sdale28/MAE-322-DynaSaRR/Final_Design_Report/appendix-calculations.tex

\subsection{Calculations}
\begin{landscape}
\begin{figure}[ht]
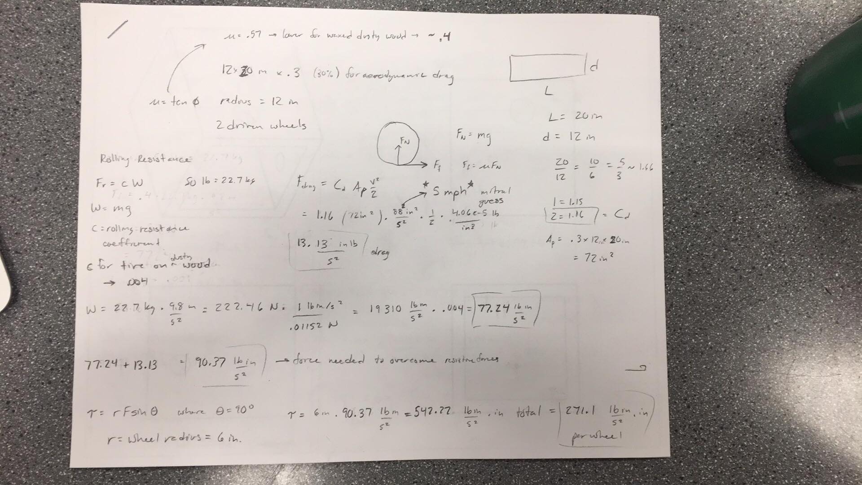
[picture p1: Final_Design_Report/Images/calculations1.png]
    
    \centering
    \caption{Numerical Values and Solutions, Part I}
\end{figure}

\vfill
\newpage

\begin{figure}[ht]
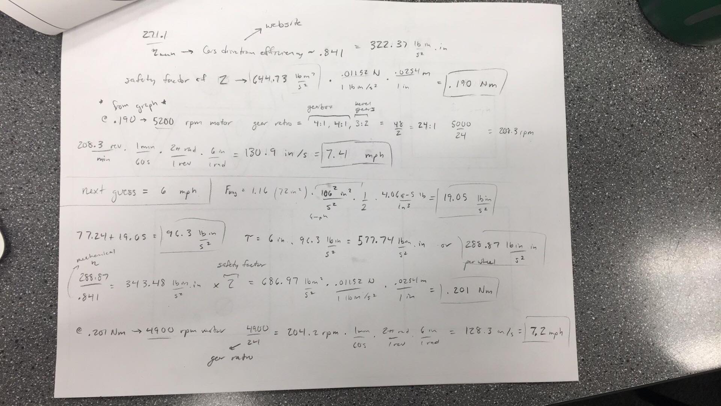
[picture p2: Final_Design_Report/Images/calculations2.png]
    
    \caption{Numerical Values and Solutions, Part II}
\end{figure}

\vfill
\newpage

\begin{figure}[ht]
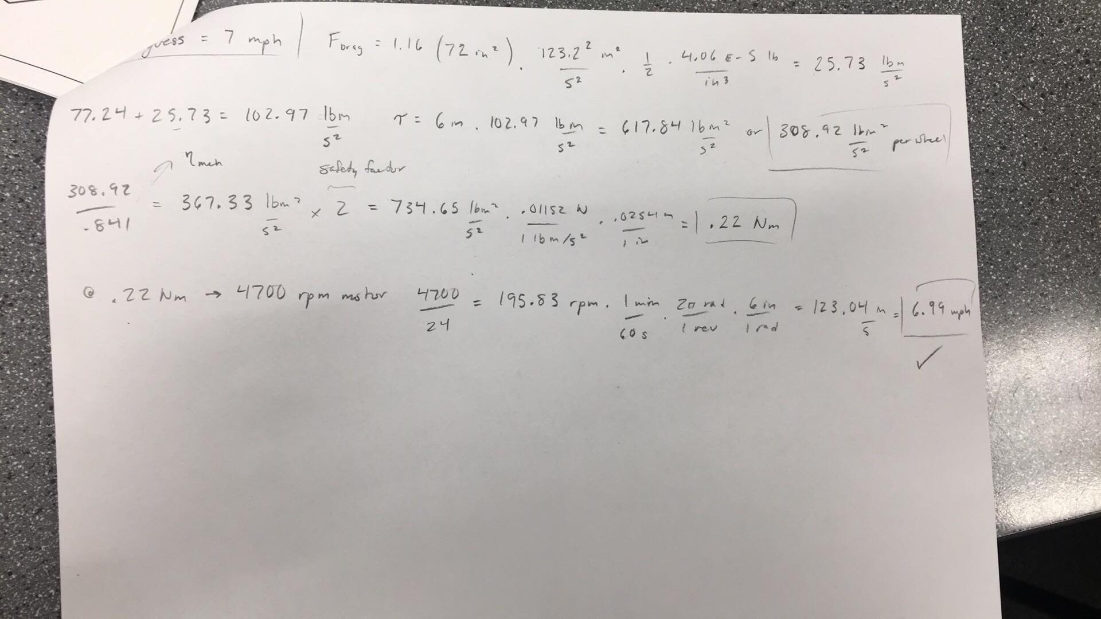
[picture p3: Final_Design_Report/Images/Calculations3.png]
    
    \caption{Numerical Values and Solutions, Part III}
\end{figure}

\vfill
\newpage

\begin{figure}[ht]
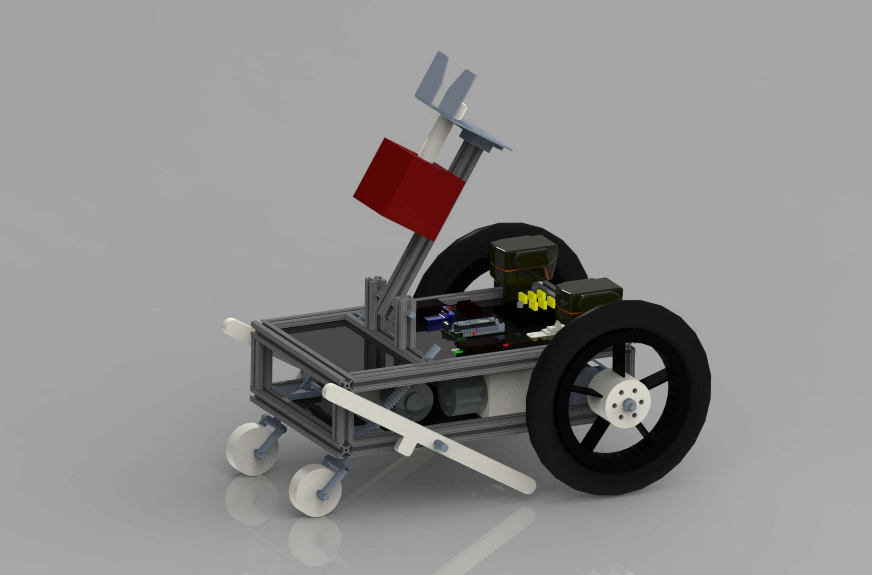
[picture p4: Final_Design_Report/Images/medkit_arm.png]
    
    \caption{Medical Kit Arm}
\end{figure}

\vfill
\newpage

\label{fig:GearStress}
\begin{figure}[ht]
    
    \caption{Gear Stress Calculations}
    \label{fig:GearStress}
\end{figure}

\vfill
\newpage
\clearpage
\end{landscape}
