sdale28/MAE-322-DynaSaRR/Final_Design_Report/appendix-drawings.tex

\subsection{Appendix III: Part and Sub-Assembly Drawings}

\begin{landscape}
\includepdf[pages={-},angle=90]{./drawings/1010_10_drawing}
\includepdf[pages={-},angle=90]{./drawings/1010_14_drawing}
\includepdf[pages={-},angle=90]{./drawings/1010_3_drawing}
\includepdf[pages={-},angle=90]{./drawings/1010_medkit_rester_drawing}
\includepdf[pages={-},angle=90]{./drawings/1010_medkit_support_drawing}
\includepdf[pages={-},angle=90]{./drawings/1010_medkitarm_final_drawing}
\includepdf[pages={-},angle=90]{./drawings/back_hub_gripper}
\includepdf[pages={-},angle=90]{./drawings/backaxle_drawing}
\includepdf[pages={-},angle=90]{./drawings/backwheel_motor_mount}
\includepdf[pages={-},angle=90]{./drawings/baxle}
\includepdf[pages={-},angle=90]{./drawings/bottom_poly_cnc}
\includepdf[pages={-},angle=90]{./drawings/chain_guard}
\includepdf[pages={-},angle=90]{./drawings/coupling_drawing}
\includepdf[pages={-},angle=90]{./drawings/cross_bar}
\includepdf[pages={-},angle=90]{./drawings/fork_mount_v3_left_drawing}
\includepdf[pages={-},angle=90]{./drawings/front_axle_drawing}
\includepdf[pages={-},angle=90]{./drawings/front_fork}
\includepdf[pages={-},angle=90]{./drawings/front_wheel_drawing}
\includepdf[pages={-},angle=90]{./drawings/gear_box}
\includepdf[pages={-},angle=90]{./drawings/gearbox_support}
\includepdf[pages={-},angle=90]{./drawings/grabber_drawing}
\includepdf[pages={-},angle=90]{./drawings/half-t-slot-v2}
\includepdf[pages={-},angle=90]{./drawings/hub_gripper_rear_drawing}
\includepdf[pages={-},angle=90]{./drawings/lifting_arm_axle_drawing}
\includepdf[pages={-},angle=90]{./drawings/lifting_arm_drawing}
\includepdf[pages={-},angle=90]{./drawings/lifting_arm_metal_gripper}
\includepdf[pages={-},angle=90]{./drawings/Lifting_Arm_Motor_Support_Cross}
\includepdf[pages={-},angle=90]{./drawings/lifting_arm_mount}
\includepdf[pages={-},angle=90]{./drawings/lifting_arm_support_cross}
\includepdf[pages={-},angle=90]{./drawings/lifting_arm_washer_plate}
\includepdf[pages={-},angle=90]{./drawings/lifting_motor_mount}
\includepdf[pages={-},angle=90]{./drawings/}
\includepdf[pages={-},angle=90]{./drawings/light-sensor_tap}
\includepdf[pages={-},angle=90]{./drawings/medkit_arm_gear_spacer_drawing}
\includepdf[pages={-},angle=90]{./drawings/medkit_axle_drawing}
\includepdf[pages={-},angle=90]{./drawings/medkit_grabber_attchmnt_drawing}
\includepdf[pages={-},angle=90]{./drawings/medkit_limit_switch_holder_frnt}
\includepdf[pages={-},angle=90]{./drawings/medkit_limit_switch_holder_rear}
\includepdf[pages={-},angle=90]{./drawings/medkit_motor_mount_bottom}
\includepdf[pages={-},angle=90]{./drawings/medkit_motor_mount_top}
\includepdf[pages={-},angle=90]{./drawings/medkit_secure_l_beam}
\includepdf[pages={-},angle=90]{./drawings/medkit_washer_plate_drawing_bottom}
\includepdf[pages={-},angle=90]{./drawings/top_cross_bar}
\includepdf[pages={-},angle=90]{./drawings/washer-plate-drawing.pdf}

\end{landscape}
