sdale28/MAE-322-DynaSaRR/Final_Design_Report/drawings.tex

\section{Creo Rendering and Drawings of Important Sub-Assemblies}

\begin{figure}[ht]
    \centering
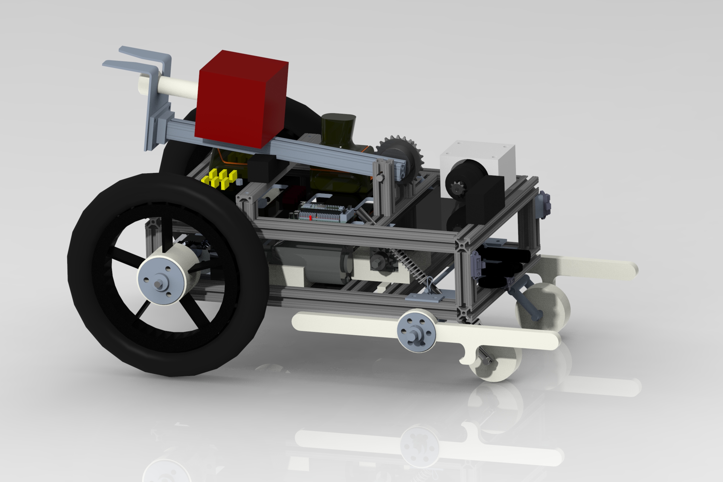
[picture p24: Final_Design_Report/Images/FDR_pretty_picture_2.jpg]
    
    \caption{Final rendering of DynaSaRR}
\end{figure}

\begin{landscape}
\includepdf[pages={-},angle=90]{./drawings/front_wheel_subassembly}
\includepdf[pages={-},angle=90]{./drawings/gearbox_subassembly_drawing}
\includepdf[pages={-},angle=90]{./drawings/medkit_subassembly_v2}
\end{landscape}
