sdale28/MAE-322-DynaSaRR/Final_Design_Report/final-report.tex

\documentclass[12pt]{article}
\usepackage[english]{babel}
\usepackage[utf8x]{inputenc}
\usepackage{amsmath}
\usepackage{graphicx}
\usepackage[colorinlistoftodos]{todonotes}
\usepackage{array}
\usepackage{multirow}
\usepackage{tabularx}
\usepackage{textcomp}
\usepackage{gensymb}
\usepackage{listings}
\usepackage{courier}
\usepackage{fancyhdr}
\usepackage{nameref}
\usepackage{pdflscape}
\usepackage{rotating}
\usepackage{csvsimple}
\usepackage{longtable}
\usepackage{pdfpages}

\input{./resources/commands.tex}
\graphicspath{ {Images/} }

\input{./resources/arduinoLanguage.tex}
\input{./resources/arduinoStyle.tex}

\begin{document}

\frontmatter
\input{./resources/title-page.tex}
\input{executive-summary.tex}

\tableofcontents
\newpage

\mainmatter
\input{introduction.tex}
\input{project-management.tex}
\input{detailed-design-and-analysis.tex}
\input{specifications.tex}
\input{drawings.tex}
\input{test-results.tex}
\input{further-work-and-conclusions.tex}

\backmatter
\section{Appendices}
\input{appendix-calculations.tex}
%\input{appendix-logbook.tex}
\input{appendix-bill-of-materials.tex}
\input{appendix-code.tex}
\input{appendix-drawings.tex}

\end{document}
