sdale28/MAE-322-DynaSaRR/Final_Design_Report/resources/title-page.tex

% Title page template downloaded from: 
% https://www.overleaf.com/latex/examples/title-page-with-logo/hrskypjpkrpd

%\documentclass[12pt]{article}
%\usepackage[english]{babel}
%\usepackage[utf8x]{inputenc}
%\usepackage{amsmath}
%\usepackage{graphicx}
%\usepackage[colorinlistoftodos]{todonotes}

%\begin{document}

\begin{titlepage}

\newcommand{\HRule}{\rule{\linewidth}{0.5mm}} % Defines a new command for the horizontal lines, change thickness here

\center % Center everything on the page
 
%-----------------------------------------------------------------------------------
%	HEADING SECTIONS
%-----------------------------------------------------------------------------------
\\[1cm]
%\textsc{\LARGE Princeton University}\\[1.5cm] % Name of your university/college
\textsc{\Large MAE 322: Mechanical Design}\\[0.5cm] % Major heading such as course name
\textsc{\large Spring 2019}\\[1cm] % Minor heading such as course title

%-----------------------------------------------------------------------------------
%	TITLE SECTION
%-----------------------------------------------------------------------------------

\HRule \\[0.6cm]
{ \huge \bfseries Final Design Report}\\[0.4cm] % Title of your document
\HRule \\[1cm]

{\Large May 14, 2019}\\[2cm] % Date, change the \today to a set date if you want to be precise

%-----------------------------------------------------------------------------------
%	Team Info
%-----------------------------------------------------------------------------------

{\large \textbf{Team:} The SaRRchaeologists}\\[1cm]
{\large \textbf{Robot:} DynaSaRR}\\[1.6cm]

\begin{minipage}[t]{0.4\textwidth}
\begin{flushleft} \large
\emph{Submitted By:}\\
Jackson Artis\\
Morgan Baker\\
Sam Dale\\
Alexandra Koskosidis\\
Evan Quinn\\
Alex Rogers
\end{flushleft}
\end{minipage}
~
\begin{minipage}[t]{0.4\textwidth}
\begin{flushright} \large
\emph{Submitted To:} \\
Prof. Daniel Nosenchuck\\
Glenn Northey\\
Al Gaillard\\
Aaron Goodman\\
\end{flushright}
\end{minipage}\\[1cm]

\vfill % Fill the rest of the page with whitespace

\end{titlepage}

%\end{document}
