sdale28/MAE-322-DynaSaRR/Final_Design_Report/team-roles.tex

%{\Large \textbf{Team Roles}}

\addcontentsline{toc}{section}{Team Roles}
\section*{Team Roles}

% \begin{minipage}[t]{0.4\textwidth}
%     \begin{itemize}
%     \item Column 2 content 1
%     \item Column 2 content 2
%     \end{itemize}
%   \end{minipage}

\begin{center}
\resizebox{\textwidth}{!}{
\begin{tabular}{ |c|c|c|c| } 
    \hline
    \textbf{Name} & \textbf{Responsible For} \\
    \hline
    Jackson Artis & CAD Modeling \\
    \hline
    Morgan Baker & Analysis \\
    \hline
    Sam Dale & Design, Electronics \\
    \hline
    Alexandra Koskosidis & Team Leader, Coding \\
    \hline
    Evan Quinn &  Manufacturing \\
    \hline
    Alex Rogers & CNC, Hardware Systems \\ 
    \hline
    
\end{tabular}}
\end{center}

\vfill % Fill the rest of the page with whitespace
\newpage
