sdale28/MAE-322-DynaSaRR/Final_Design_Report/resources/total-time_v1.csv

Person | Time | Percent of Time
Alexandra Koskosidis | 165:20 | 20.21%
Alex Rogers | 119:35 | 14.61%
Evan Quinn | 95:30 | 11.67%
Jackson Artis | 110:25 | 13.49%
Morgan Baker | 123:00 | 15.03%
Sam Dale | 204:25 | 24.98%
 | 818:15 | 100%
