sdale28/MAE-322-DynaSaRR/Final_Design_Report/Images/chassis_COM.PNG

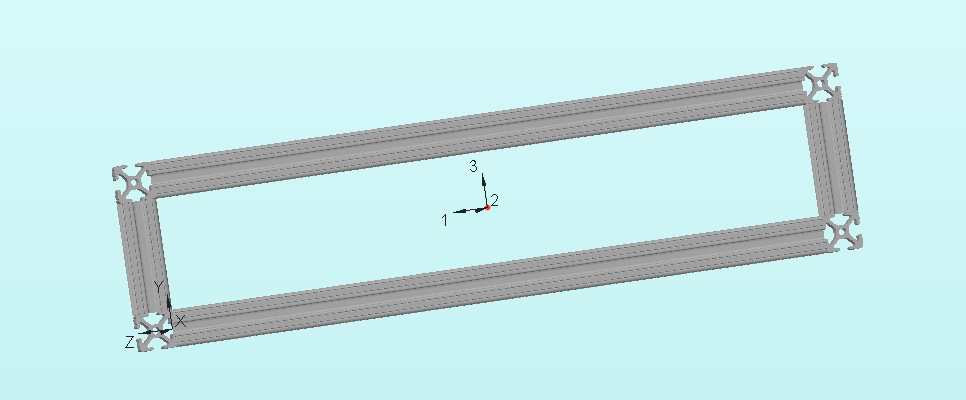
Final_Design_Report/Images/chassis_COM.PNG
