sdale28/MAE-322-DynaSaRR/Final_Design_Report/Images/Code-Diagram.png

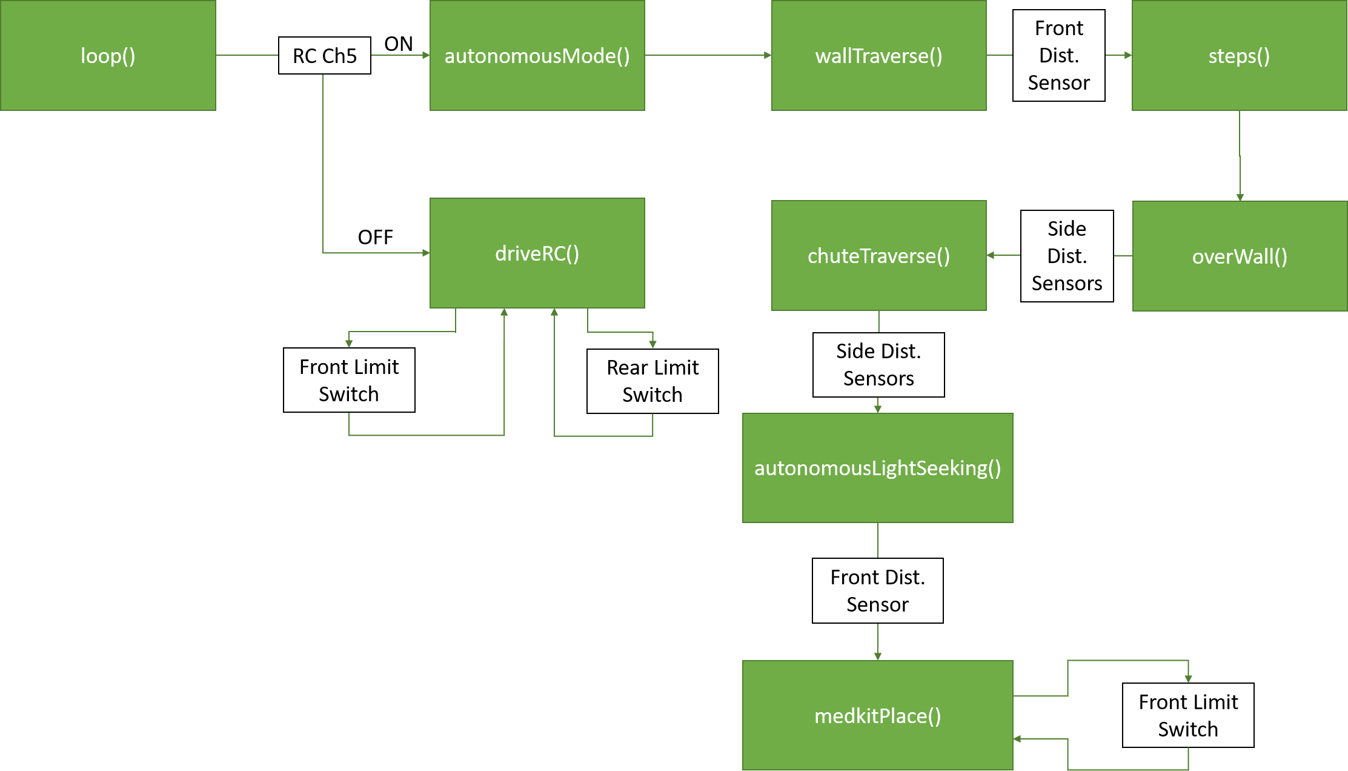
Final_Design_Report/Images/Code-Diagram.png
