sdale28/MAE-322-DynaSaRR/Final_Design_Report/appendix-bill-of-materials.tex

\begin{landscape}
\subsection{Bill of Materials}
% Please add the following required packages to your document preamble:
% \usepackage{lscape}
% \usepackage{longtable}
% Note: It may be necessary to compile the document several times to get a multi-page table to line up properly
{\footnotesize
\begin{longtable} {llllll}
\hline
Part Number & Part Name                    & Description                          & Quantity & Price Per Unit & Cost    \\ \hline
\endfirsthead
%
\endhead
%
\hline
\endfoot
%
\endlastfoot
%
6529K11     & Metal Miter Gear             & 16 Pitch, 16 Teeth                   & 2        & \$25.32        & \$50.64 \\
6529K16     & Metal Miter Gear             & 16 Pitch, 24 Teeth                   & 2        & \$32.86        & \$65.72 \\
8619K851    & HDPE Sheet                   & 6"x12"x1"                            & 1        & \$20.01        & \$20.01 \\
9657K435    & 6-Pack, Compression Spring   & 3", 0.66" OD                         & 1        & \$7.82         & \$7.82  \\
9657K437    & 6-Pack, Compression Spring   & 3", 0.72" OD                         & 1        & \$8.86         & \$8.86  \\
9620K25     & Steel Compression Spring     & 3", 0.781" OD                        & 1        & \$4.37         & \$4.37  \\
9414T8      & Set Screw Collar             & 3/8" Diameter                        & 8        & \$1.30         & \$10.40 \\
92391A120   & 25-Pack Hairpin Cotter Pin   & 1/4"-1/2" Clevis Diameter            & 1        & \$8.00         & \$8.00  \\
92949A540   & 50-Pack Button Head Screw    & 1/4"-20, 3/4" Long                   & 1        & \$7.39         & \$7.39  \\
87225K62    & Clear Polycarbonate Sheet    & 12"x24"x1/4"                         & 1        & \$26.13        & \$26.13 \\
8624K46     & HDPE Rod                     & 3"x1'                                & 1        & \$23.10        & \$23.10 \\
6546K31     & 6061 Aluminum Rect. Tube     & 1/4" thick, 2.5"x2.5", 1/2'          & 1        & \$19.08        & \$19.08 \\
47065T68    & T-Slotted Framing            & 1"x1/2"x2'                           & 1        & \$7.98         & \$7.98  \\
6338K414    & Sleeve Bearing               & 3/8" SD, 1/2" HD, 1/4" long          & 4        & \$0.74         & \$2.96  \\
7297K15     & Plastic Miter Gear           & 24 Pitch, 24 Teeth                   & 2        & \$5.39         & \$10.78 \\
7297K17     & Plastic Miter Gear           & 24 Pitch, 36 Teeth                   & 2        & \$5.44         & \$10.88 \\
6338K411    & Sleeve Bearing               & 1/4" SD, 3/8" HD                     & 4        & \$0.67         & \$2.68  \\
6338K462    & Sleeve Bearing               & 7/16" SD, 9/16" HD                   & 4        & \$1.12         & \$4.48  \\
47065t95    & 1" 80/20                     & 2ft long                             & 1        & \$7.79         & \$7.79  \\
6338K421    & Sleeve Bearing               & 1/2'' SD, 5/8'' HD, 1'' long         & 2        & \$1.44         & \$2.88  \\
1346K18     & Steel Shaft                  & 1/2" diameter, 24" long              & 1        & \$17.47        & \$17.47 \\
8671K73     & HDPE Bar                     & 4"x1/2"x4'                           & 4        & \$5.29         & \$21.16 \\
92949A540   & 50-Pack Button Head Screw    & 1/4"-20, 3/4" Long                   & 1        & \$7.39         & \$7.39  \\
98381A508   & 50-Pack Dowel Pin            & 3/16" diameter, 3/4" long            & 1        & \$7.80         & \$7.80  \\
8893K178    & Drill Rod                    & 0.1875" diameter, 3' long            & 1        & \$4.30         & \$4.30  \\
47065T95    & T-Slotted Framing            & 1" High x 1" Wide, Solid             & 1        & \$7.79         & \$7.79  \\
89015K18    & 6061 Aluminum Sheet          & 1/8" Thick, 12" x 12"                & 1        & \$27.71        & \$27.71 \\
6338K312    & Brass Flanged Sleeve Bearing & 5/8" Flange OD                       & 6        & \$1.12         & \$6.72  \\
9414T8      & Set Screw Shaft Collar       & for 3/8" Diameter, 1215 Carbon Steel & 2        & \$1.30         & \$2.60  \\ \hline
\end{longtable}
\end{landscape}
}
