sdale28/MAE-322-DynaSaRR/Final_Design_Report/drawings/1010_10_drawing.pdf

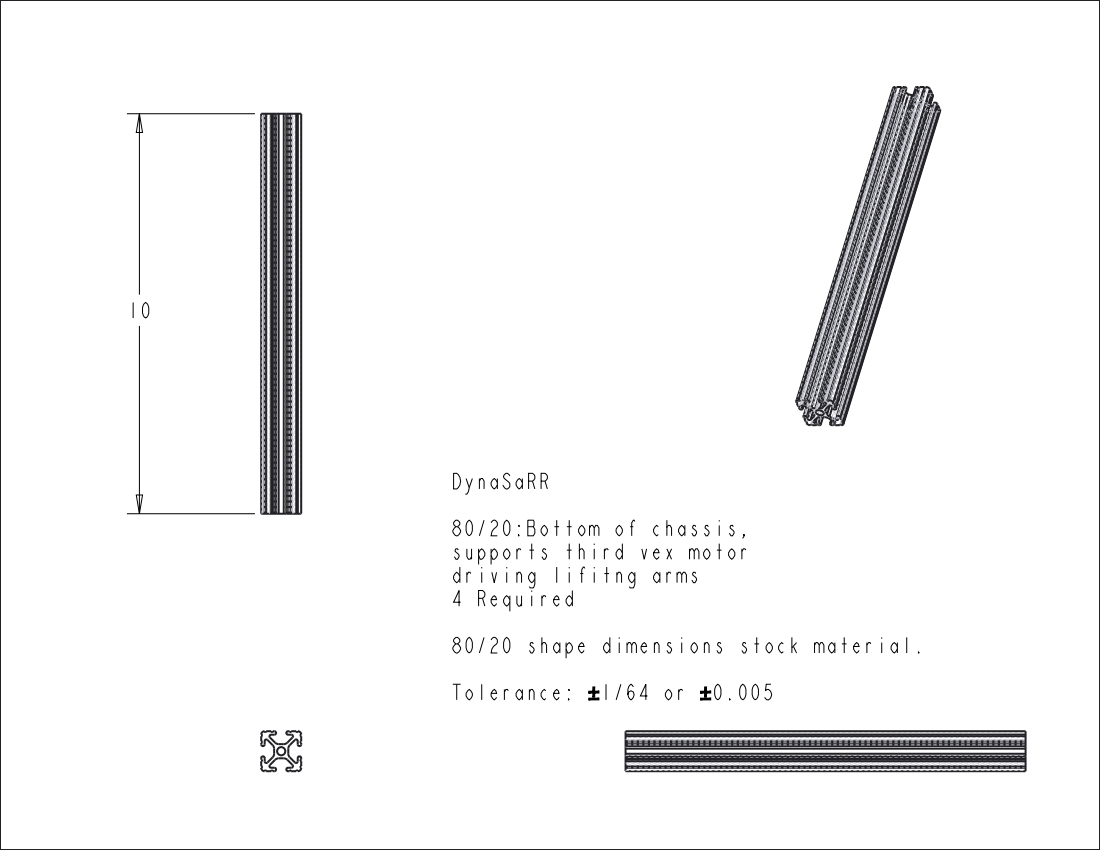
[picture p38: page 1]
supports third; vex motor; 80/20 shape dimensions stock; material.

DynaSaRR
80/20:Bottom of chassis,
driving lifitng arms
4 Required
Tolerance: 1/64 or 0.005
