sdale28/MAE-322-DynaSaRR/Final_Design_Report/drawings/1010_14_drawing.pdf

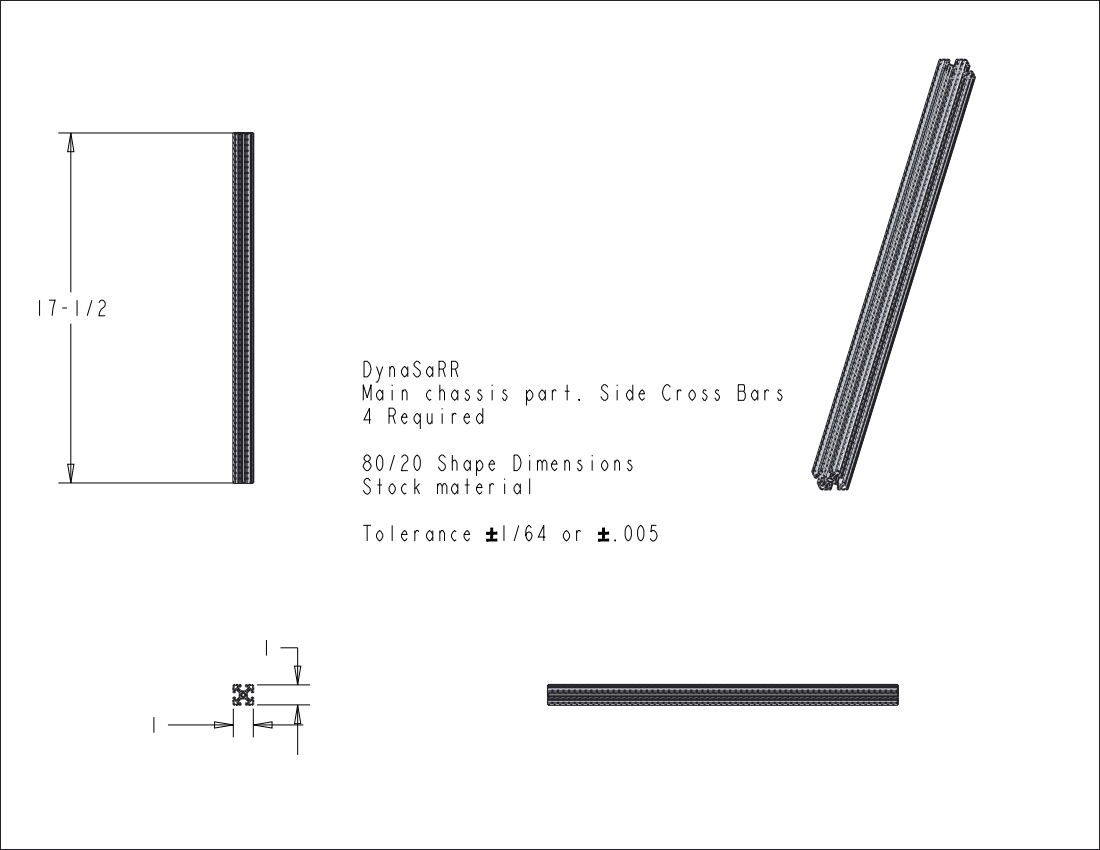
[picture p39: page 1]

DynaSaRR
Main chassis part. Side Cross Bars
4 Required
80/20 Shape Dimensions
Stock material
Tolerance 1/64 or .005
