sdale28/MAE-322-DynaSaRR/Final_Design_Report/drawings/1010_3_drawing.pdf

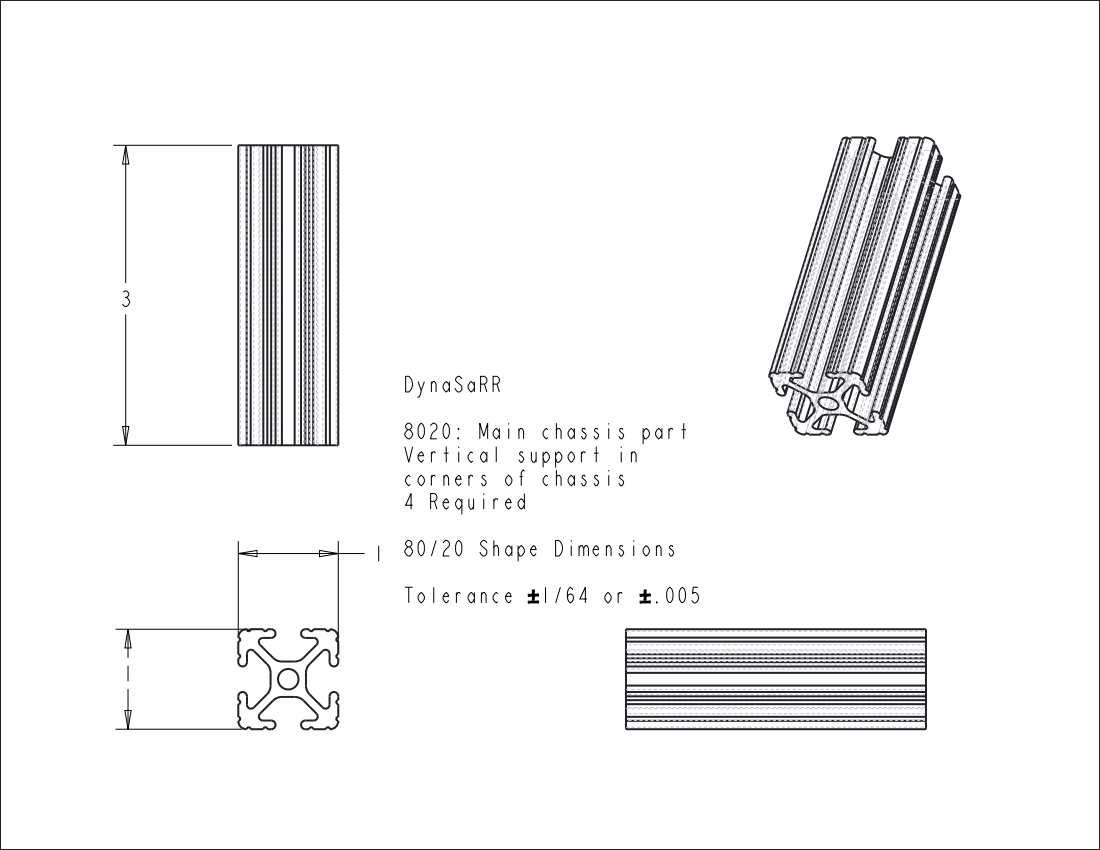
[picture p40: page 1]

DynaSaRR
8020: Main chassis part
Vertical support in
corners of chassis
4 Required
80/20 Shape Dimensions
Tolerance 1/64 or .005
