sdale28/MAE-322-DynaSaRR/Final_Design_Report/drawings/1010_medkit_rester_drawing.pdf

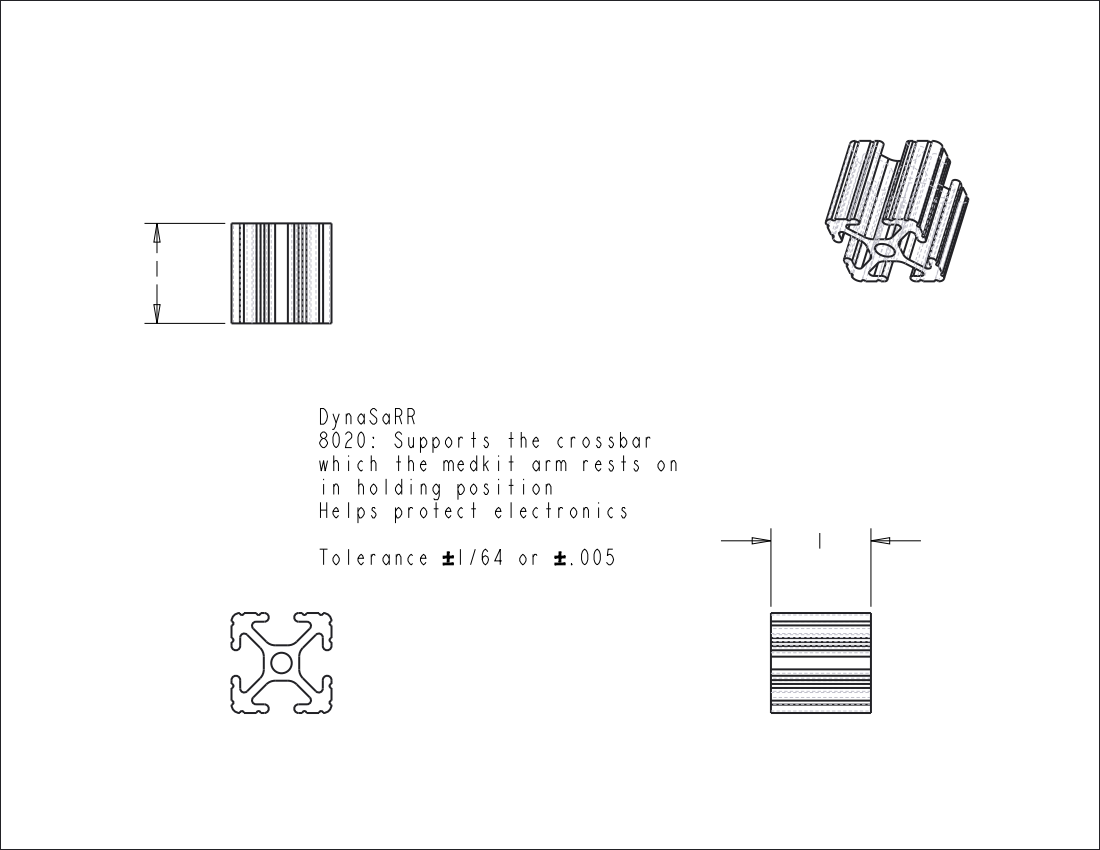
[picture p41: page 1]
which the medkit; arm rests on

DynaSaRR
8020: Supports the crossbar
in holding position
Helps protect electronics
Tolerance 1/64 or .005
