sdale28/MAE-322-DynaSaRR/Final_Design_Report/drawings/1010_medkit_support_drawing.pdf

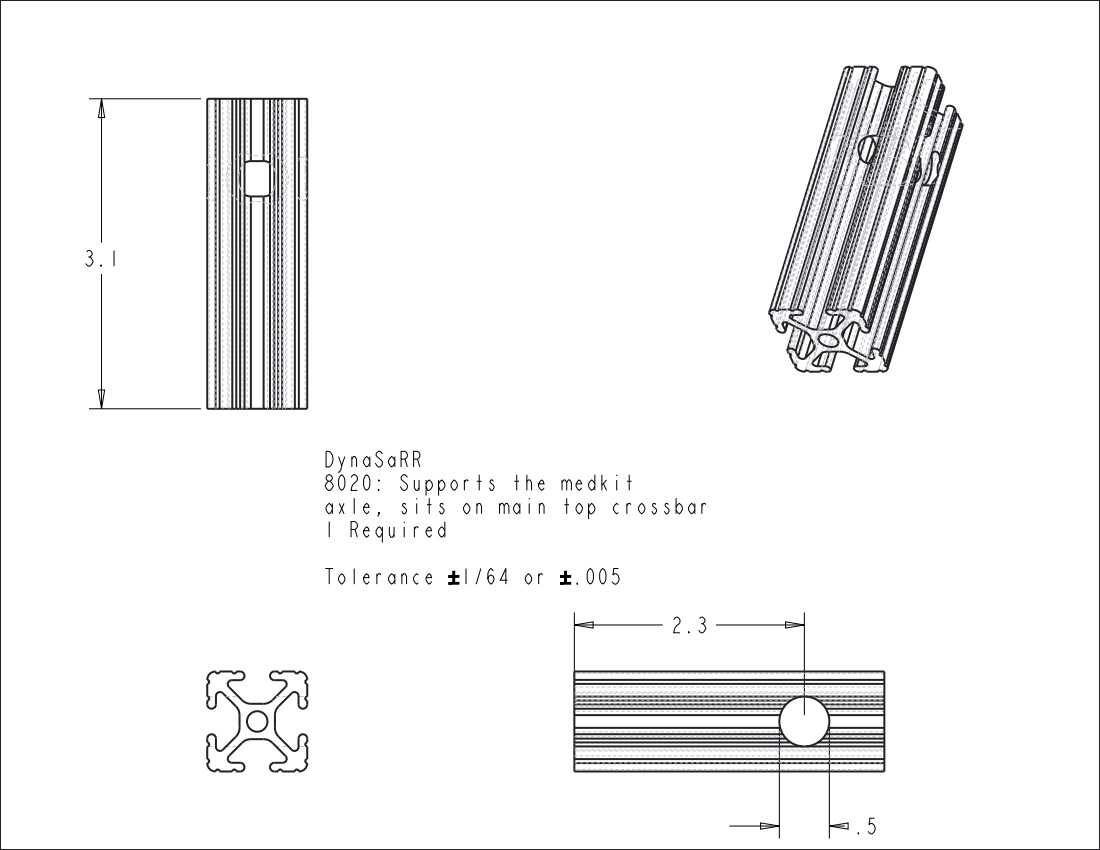
[picture p42: page 1]

DynaSaRR
8020: Supports the medkit
axle, sits on main top crossbar
1 Required
Tolerance 1/64 or .005
