sdale28/MAE-322-DynaSaRR/Final_Design_Report/drawings/1010_medkitarm_final_drawing.pdf

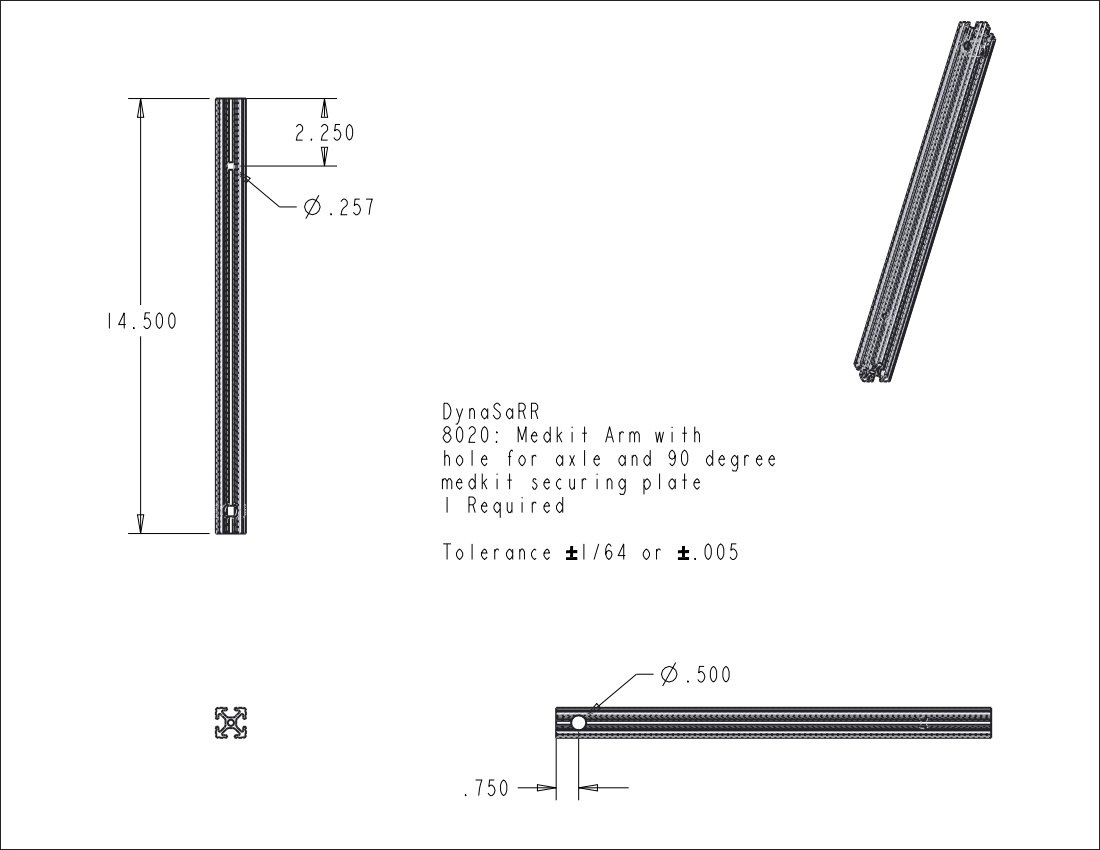
[picture p43: page 1]
hole for axle and; 90 degree

DynaSaRR
8020: Medkit Arm with
medkit securing plate
1 Required
Tolerance 1/64 or .005
