sdale28/MAE-322-DynaSaRR/Final_Design_Report/drawings/90_degree_gearbox_support_drawi.pdf

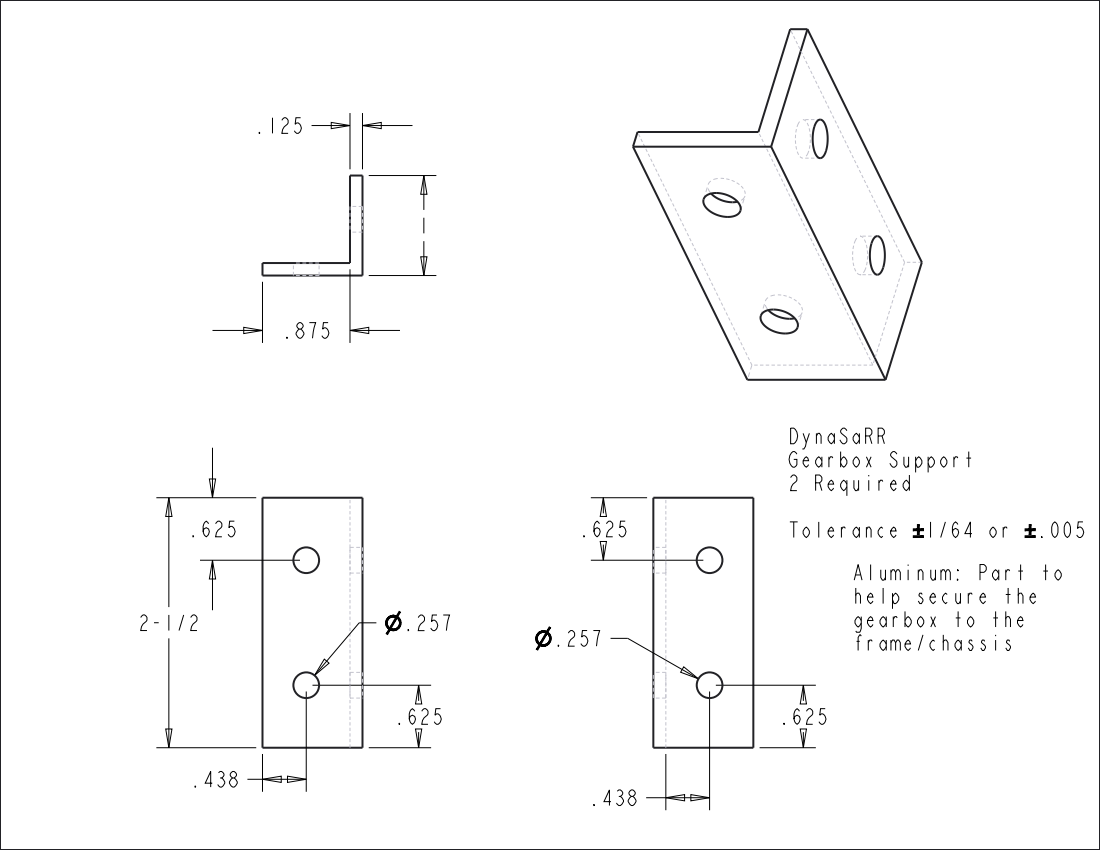
[picture p44: page 1]

DynaSaRR
Gearbox Support
2 Required
Tolerance 1/64 or .005
Aluminum: Part to
help secure the
gearbox to the
frame/chassis
