sdale28/MAE-322-DynaSaRR/Final_Design_Report/drawings/back_hub_gripper.pdf

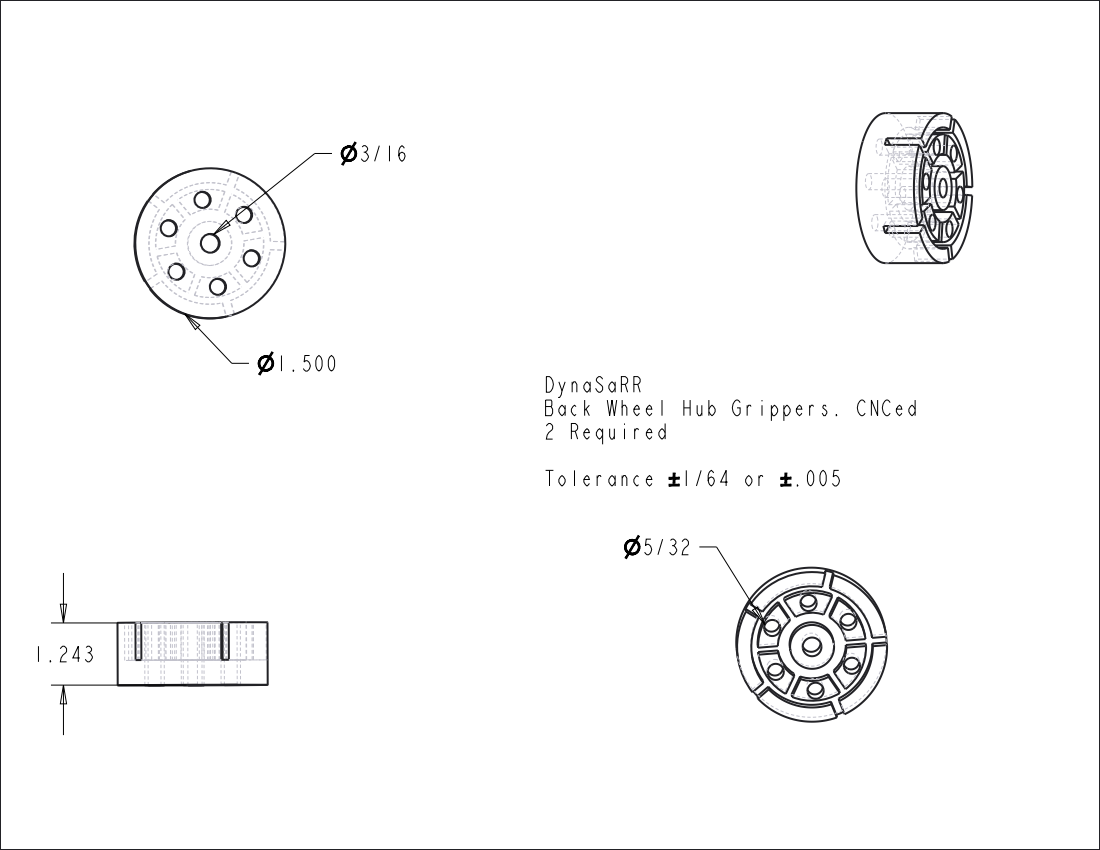
[picture p45: page 1]

DynaSaRR
Back Wheel Hub Grippers. CNCed
2 Required
Tolerance 1/64 or .005
