sdale28/MAE-322-DynaSaRR/Final_Design_Report/drawings/backaxle_drawing.pdf

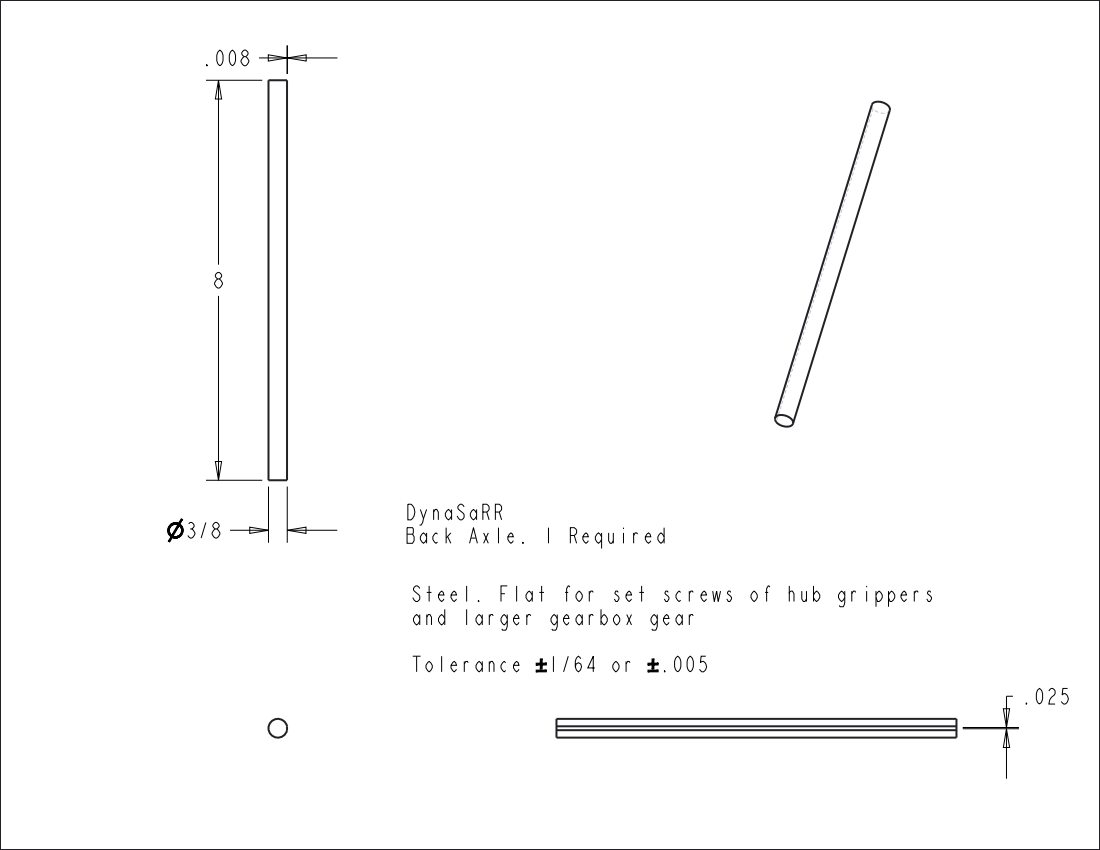
[picture p46: page 1]
Steel. Flat for set; screws of hub; grippers

DynaSaRR
Back Axle. 1 Required
and larger gearbox gear
Tolerance 1/64 or .005
