sdale28/MAE-322-DynaSaRR/Final_Design_Report/drawings/backwheel_motor_mount.pdf

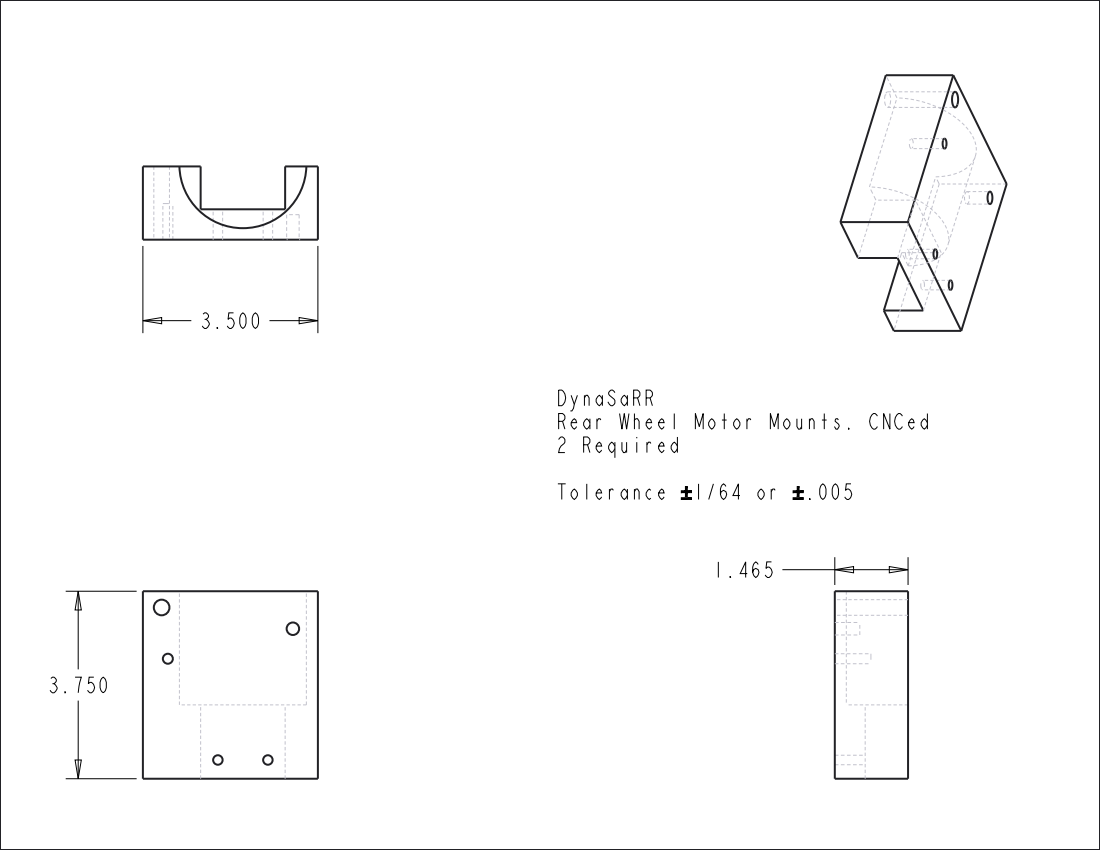
[picture p47: page 1]

DynaSaRR
Rear Wheel Motor Mounts. CNCed
2 Required
Tolerance 1/64 or .005
