sdale28/MAE-322-DynaSaRR/Final_Design_Report/drawings/baxle.pdf

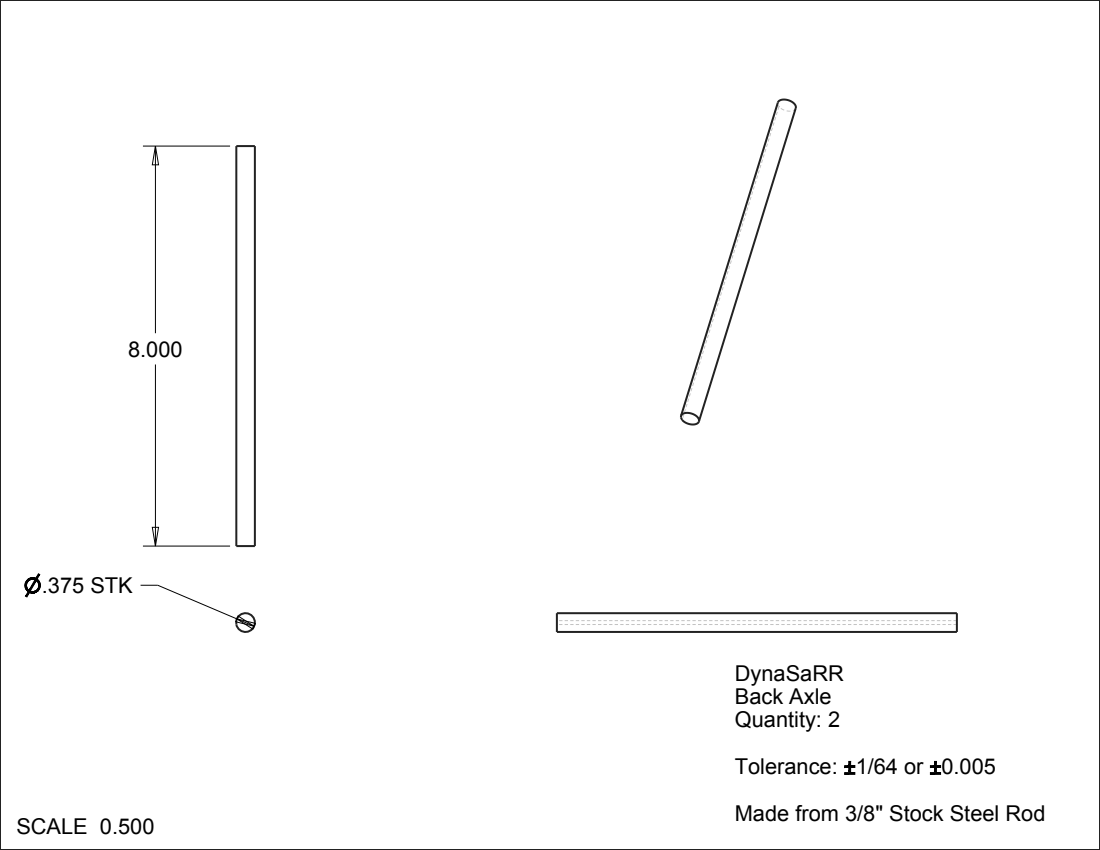
[picture p48: page 1]
.375 STK; DynaSaRR Back Axle Quantity: 2; Tolerance: 1/64 or 0.005

Made from 3/8" Stock Steel Rod SCALE 0.500
