sdale28/MAE-322-DynaSaRR/Final_Design_Report/drawings/bottom_poly_cnc.pdf

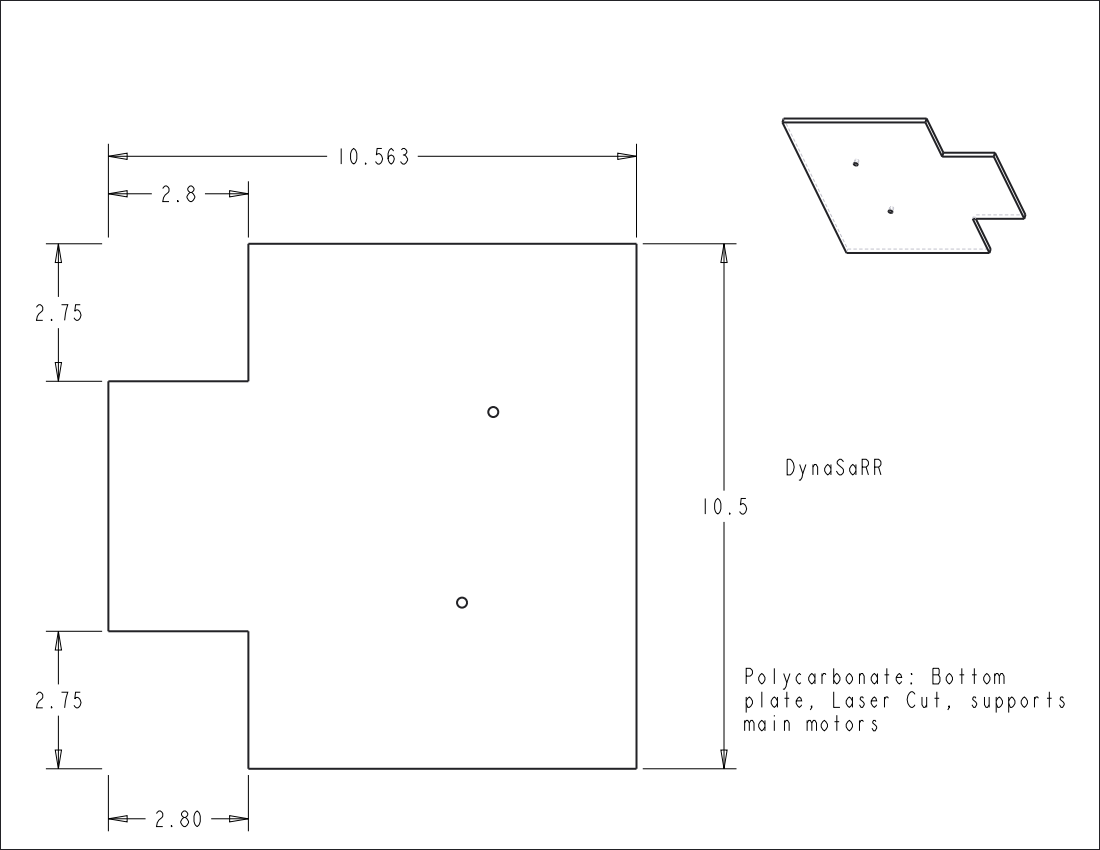
[picture p49: page 1]
DynaSaRR

Polycarbonate: Bottom
plate, Laser Cut, supports
main motors
