sdale28/MAE-322-DynaSaRR/Final_Design_Report/drawings/chain_guard.pdf

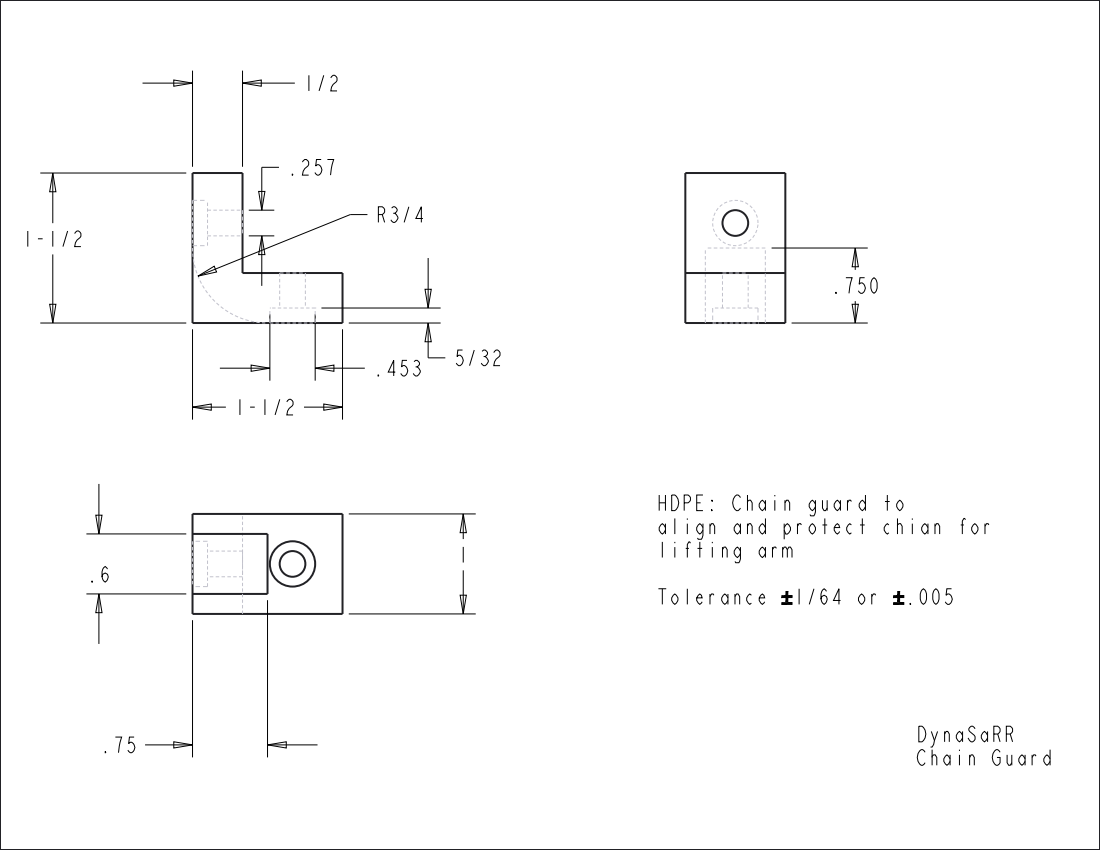
[picture p50: page 1]
DynaSaRR Chain Guard; HDPE: Chain guard; align and; protect; chian for; lifting arm Tolerance 1/64 or .005
