sdale28/MAE-322-DynaSaRR/Final_Design_Report/drawings/coupling_drawing.pdf

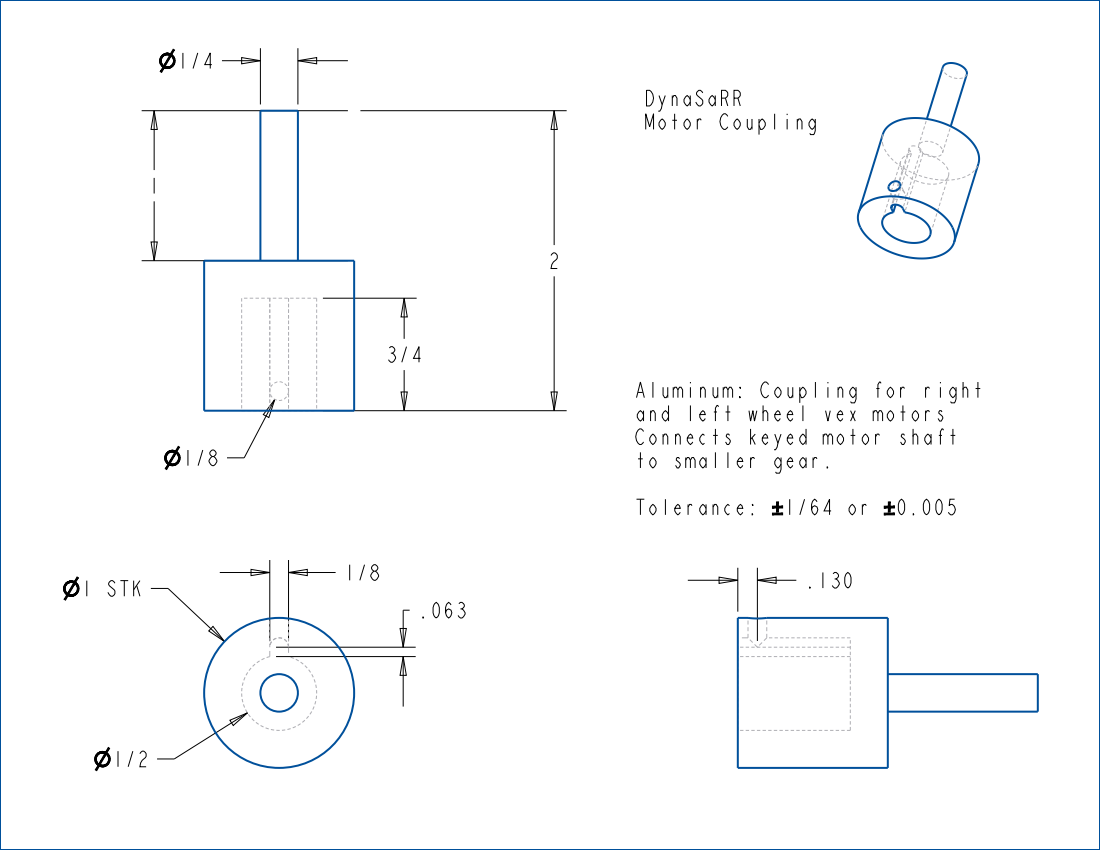
[picture p51: page 1]
1 STK; Connects keyed; motor shaft; DynaSaRR Motor Coupling

Aluminum: Coupling for right
and left wheel vex motors
to smaller gear.
Tolerance: 1/64 or 0.005
