sdale28/MAE-322-DynaSaRR/Final_Design_Report/drawings/fork_mount_v3_left_drawing.pdf

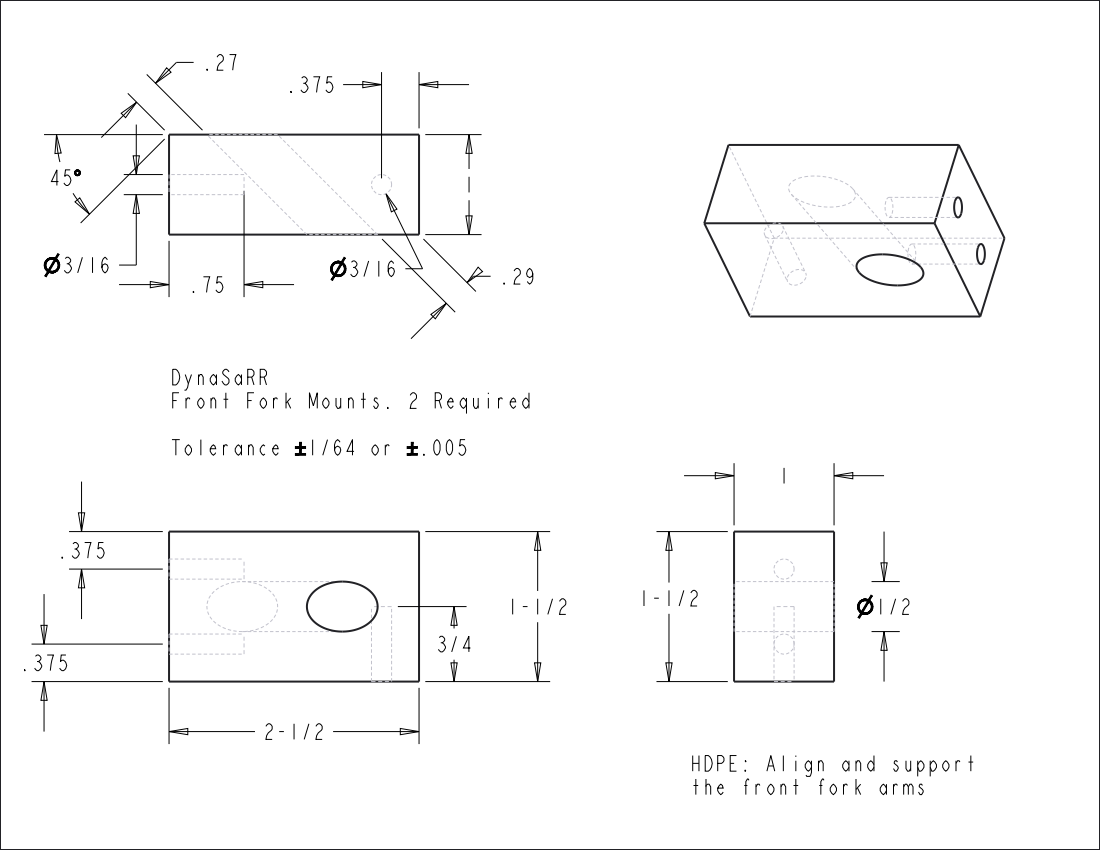
[picture p52: page 1]
HDPE: Align and; support

DynaSaRR
Front Fork Mounts. 2 Required
Tolerance 1/64 or .005

the front fork arms
