sdale28/MAE-322-DynaSaRR/Final_Design_Report/drawings/front_axle_drawing.pdf

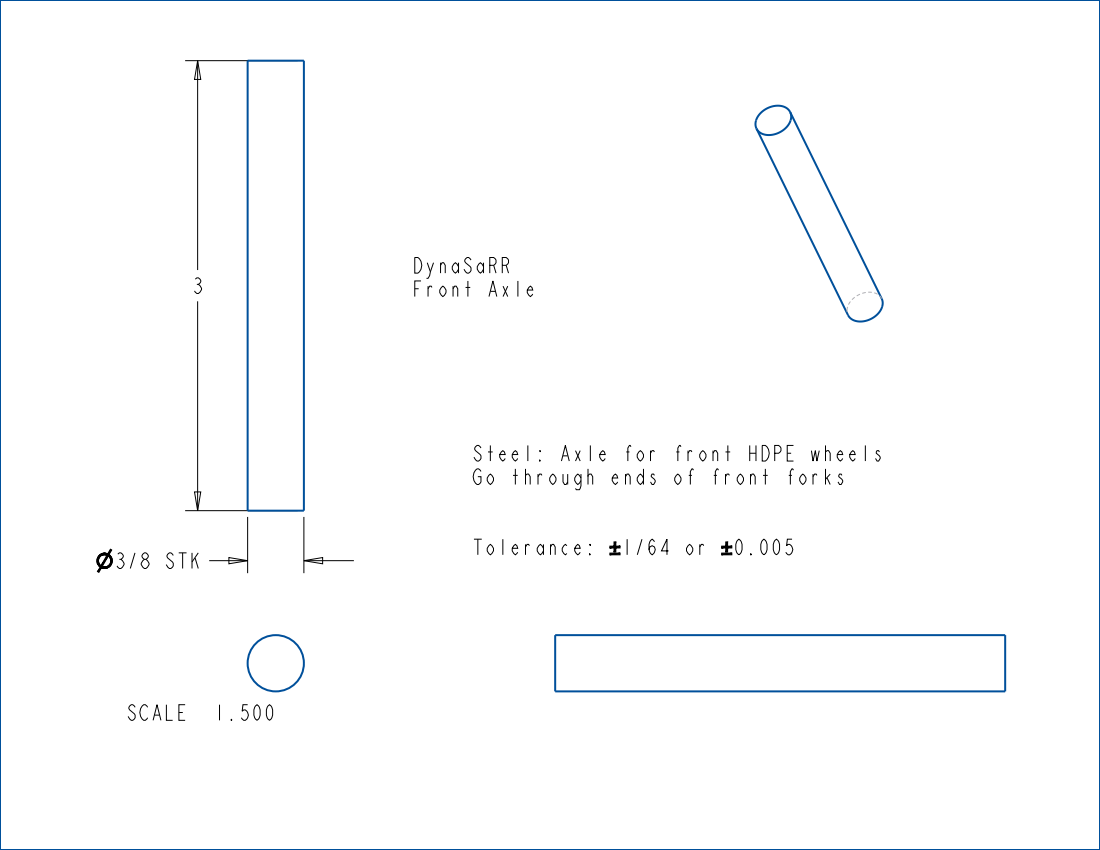
[picture p53: page 1]
3/8 STK; DynaSaRR Front Axle; Steel: Axle for front; HDPE wheels; Go through ends of front; forks; Tolerance: 1/64 or 0.005; SCALE 1.500
