sdale28/MAE-322-DynaSaRR/Final_Design_Report/drawings/front_fork.pdf

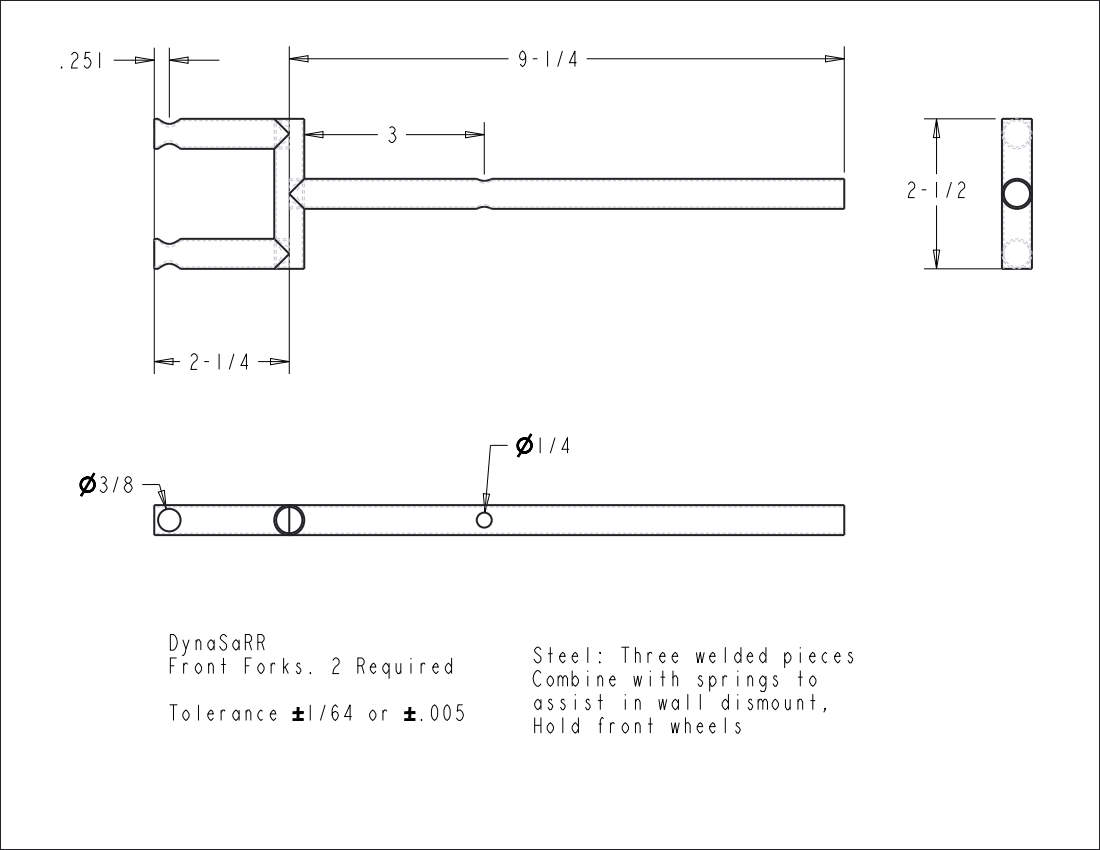
[picture p54: page 1]
Steel: Three welded; pieces

DynaSaRR
Front Forks. 2 Required
Tolerance 1/64 or .005

Combine with springs to
assist in wall dismount,
Hold front wheels
