sdale28/MAE-322-DynaSaRR/Final_Design_Report/drawings/front_wheel_drawing.pdf

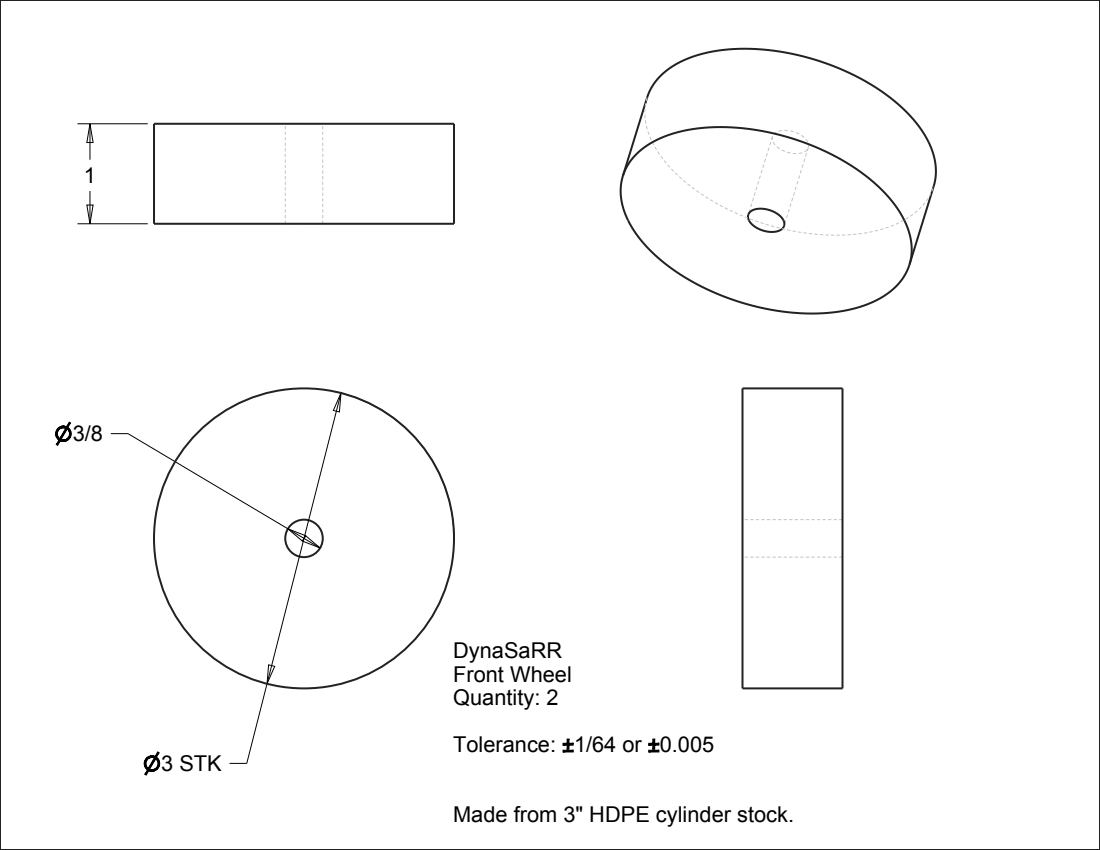
[picture p55: page 1]
3 STK; DynaSaRR Front Wheel Quantity: 2; Tolerance: 1/64 or 0.005

Made from 3" HDPE cylinder stock.
