sdale28/MAE-322-DynaSaRR/Final_Design_Report/drawings/front_wheel_subassembly.pdf

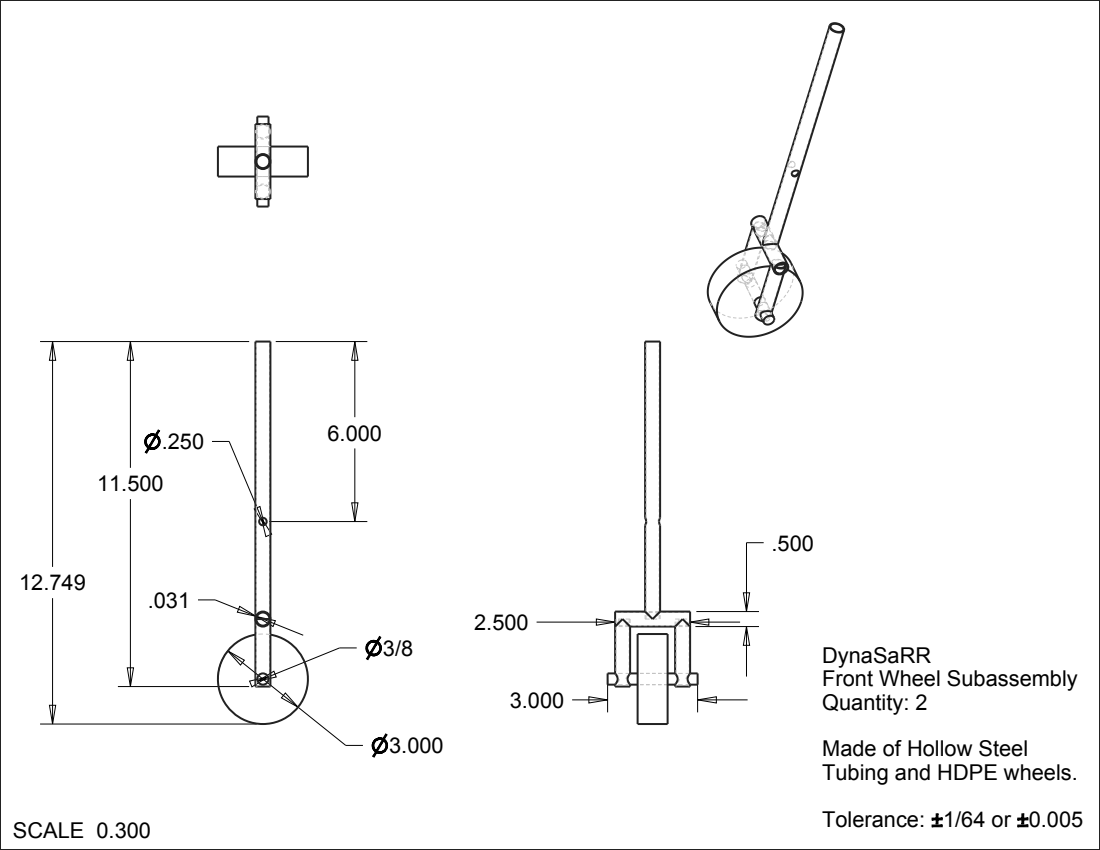
[picture p56: page 1]
DynaSaRR

Front Wheel Subassembly
Quantity: 2
Made of Hollow Steel
Tubing and HDPE wheels.

Tolerance: 1/64 or 0.005 SCALE 0.300
