sdale28/MAE-322-DynaSaRR/Final_Design_Report/drawings/gear_box.pdf

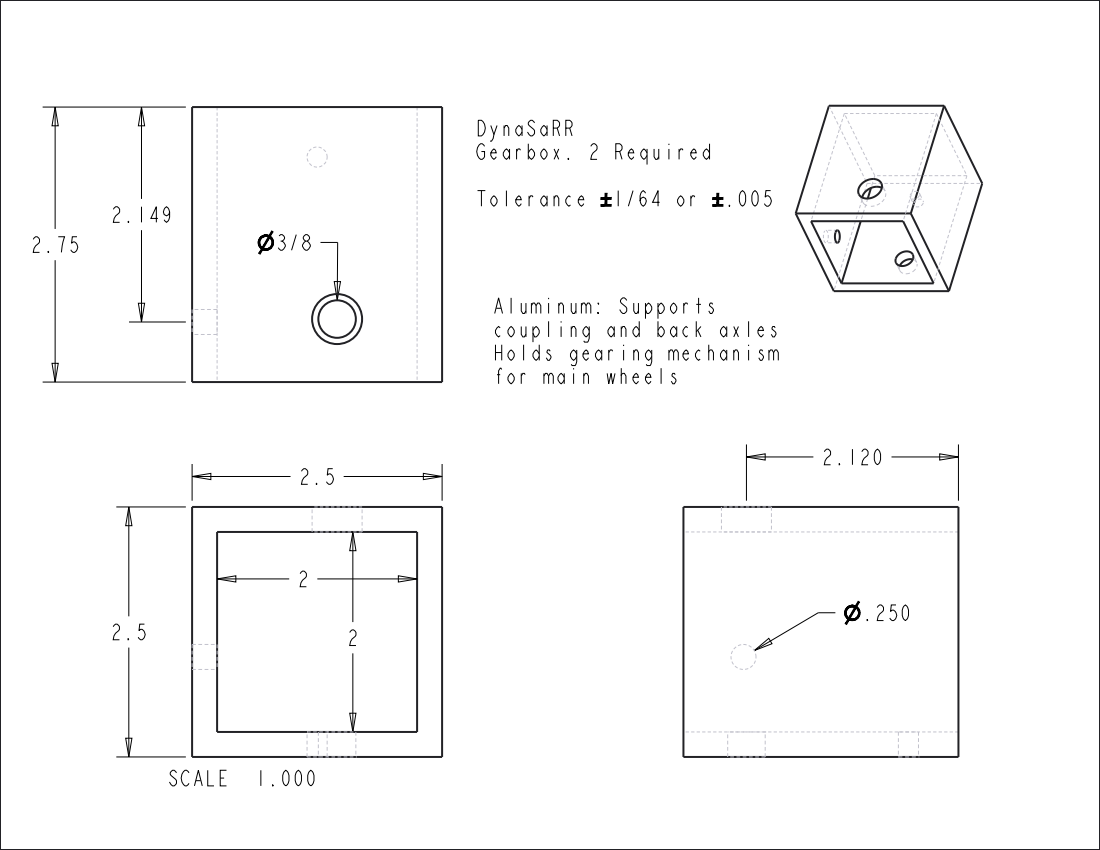
[picture p57: page 1]
DynaSaRR Gearbox. 2 Required Tolerance 1/64 or .005; coupling and; back axles; SCALE 1.000

Aluminum: Supports
Holds gearing mechanism
for main wheels
