sdale28/MAE-322-DynaSaRR/Final_Design_Report/drawings/gearbox_subassembly_drawing.pdf

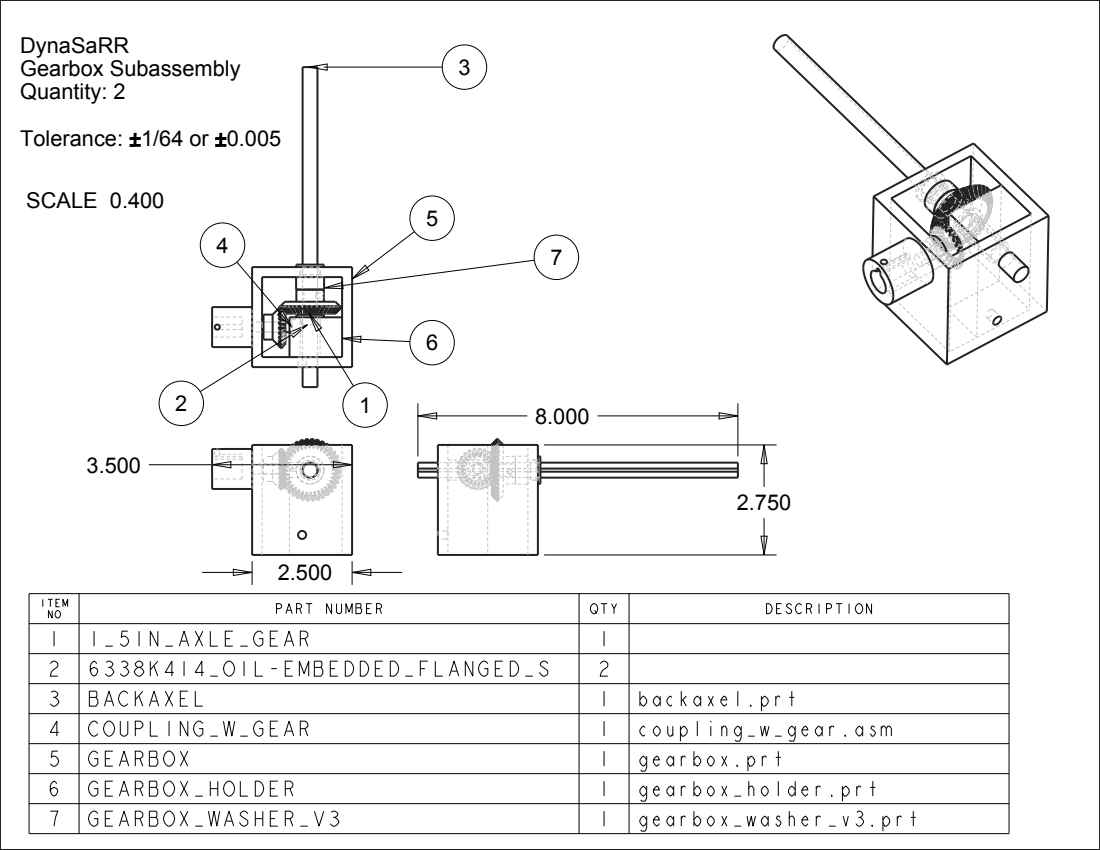
[picture p58: page 1]
ITEM; PART NUMBER; QTY; DESCRIPTION; 1 1_5IN_AXLE_GEAR; 2 6338K414_OIL-EMBEDDED_FLANGED_S; 3 BACKAXEL; 1 backaxel.prt; 4 COUPLING_W_GEAR; 1 coupling_w_gear.asm; 5 GEARBOX; 1 gearbox.prt; 6 GEARBOX_HOLDER; 1 gearbox_holder.prt; 7 GEARBOX_WASHER_V3; 1 gearbox_washer_v3.prt; DynaSaRR Gearbox Subassembly Quantity: 2; Tolerance: 1/64 or 0.005; SCALE 0.400
