sdale28/MAE-322-DynaSaRR/Final_Design_Report/drawings/gearbox_support.pdf

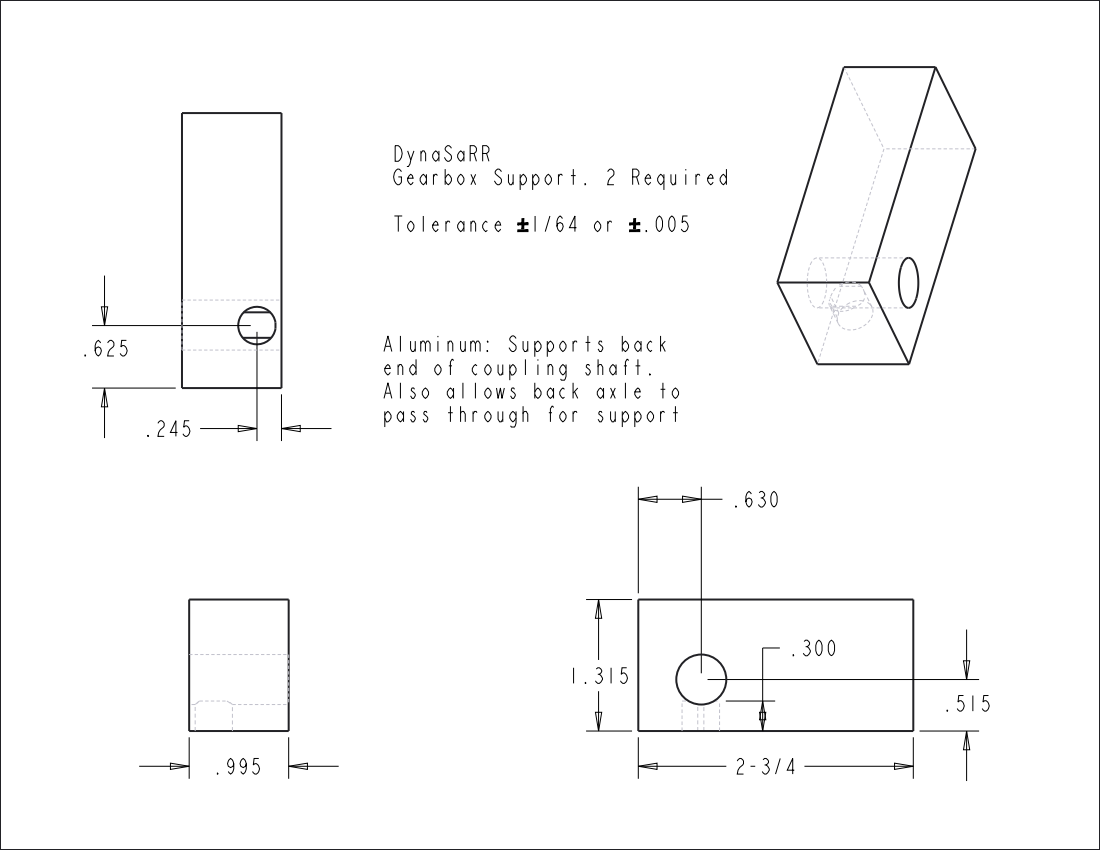
[picture p59: page 1]

DynaSaRR
Gearbox Support. 2 Required
Tolerance 1/64 or .005

Aluminum: Supports back
end of coupling shaft.
Also allows back axle to
pass through for support
