sdale28/MAE-322-DynaSaRR/Final_Design_Report/drawings/half-t-slot-v2.pdf

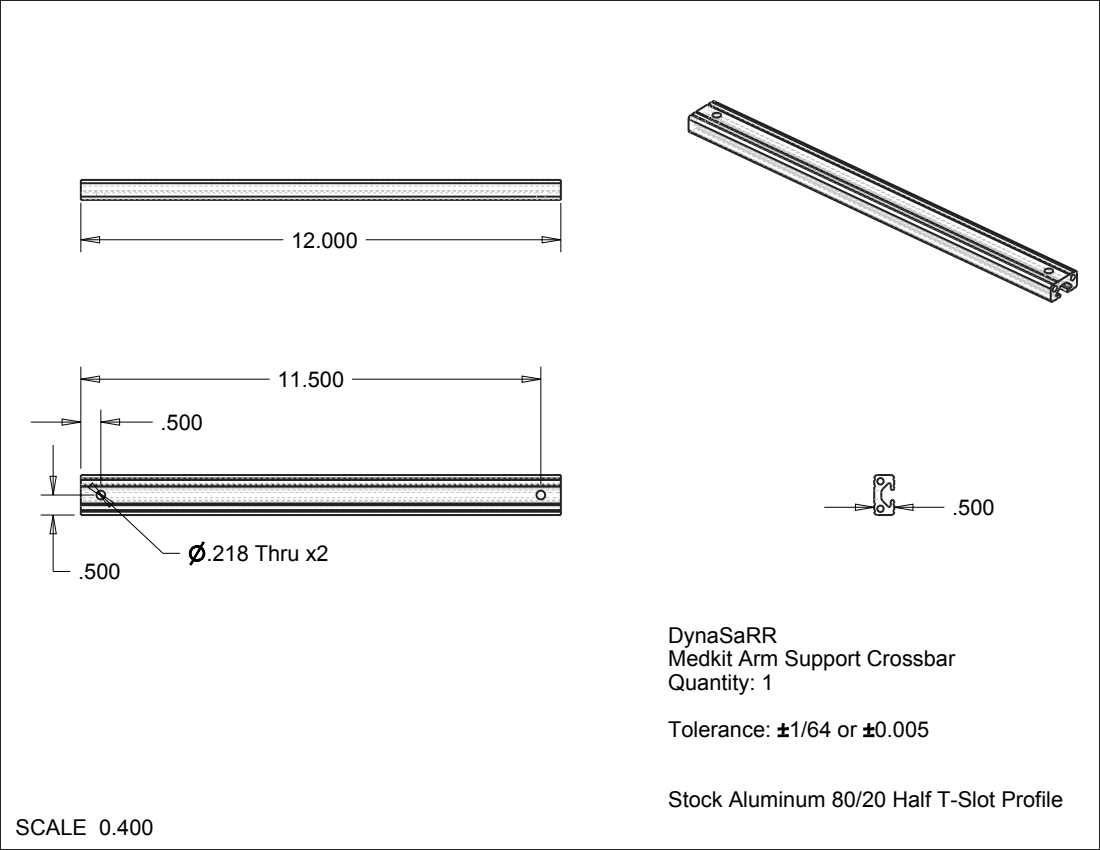
[picture p60: page 1]
.218 Thru x2; SCALE 0.400

DynaSaRR
Medkit Arm Support Crossbar
Quantity: 1
Tolerance: 1/64 or 0.005

Stock Aluminum 80/20 Half T-Slot Profile
