sdale28/MAE-322-DynaSaRR/Final_Design_Report/drawings/hub_gripper_rear_drawing.pdf

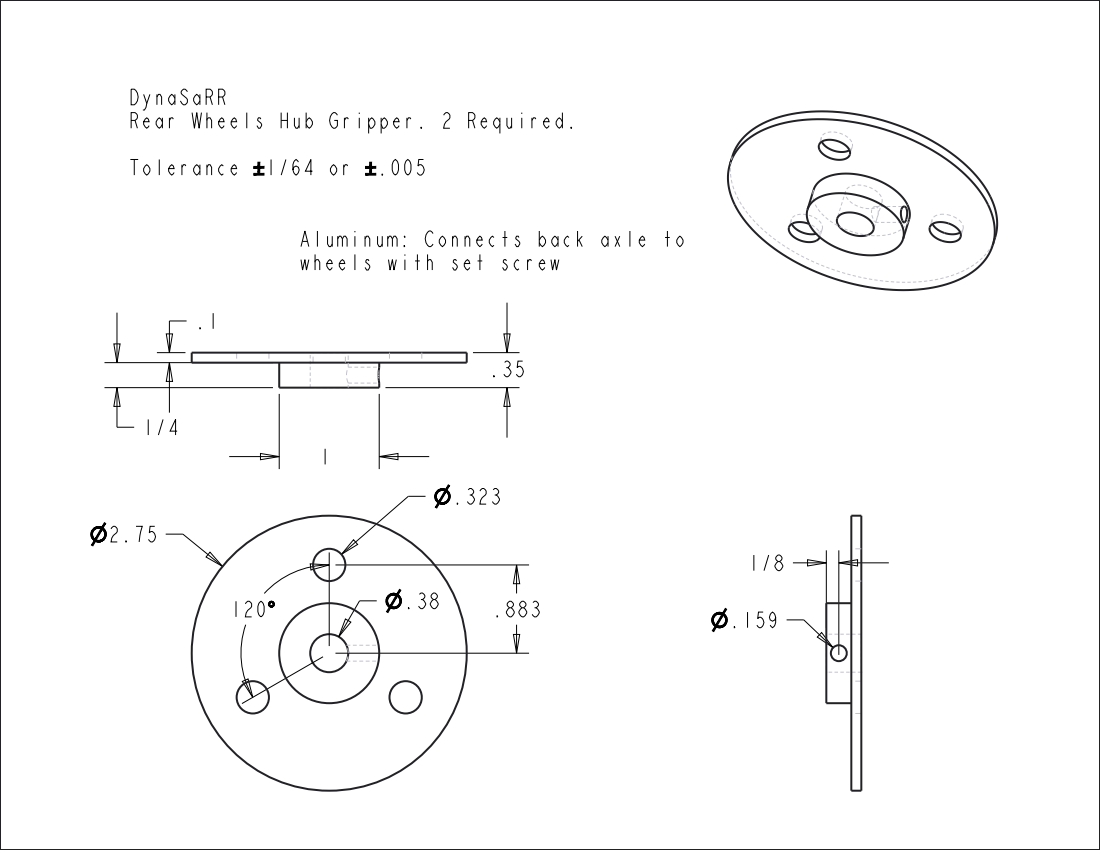
[picture p61: page 1]
Aluminum: Connects back; axle to; wheels with set; screw

DynaSaRR
Rear Wheels Hub Gripper. 2 Required.
Tolerance 1/64 or .005
