sdale28/MAE-322-DynaSaRR/Final_Design_Report/drawings/lifting_arm_axle_drawing.pdf

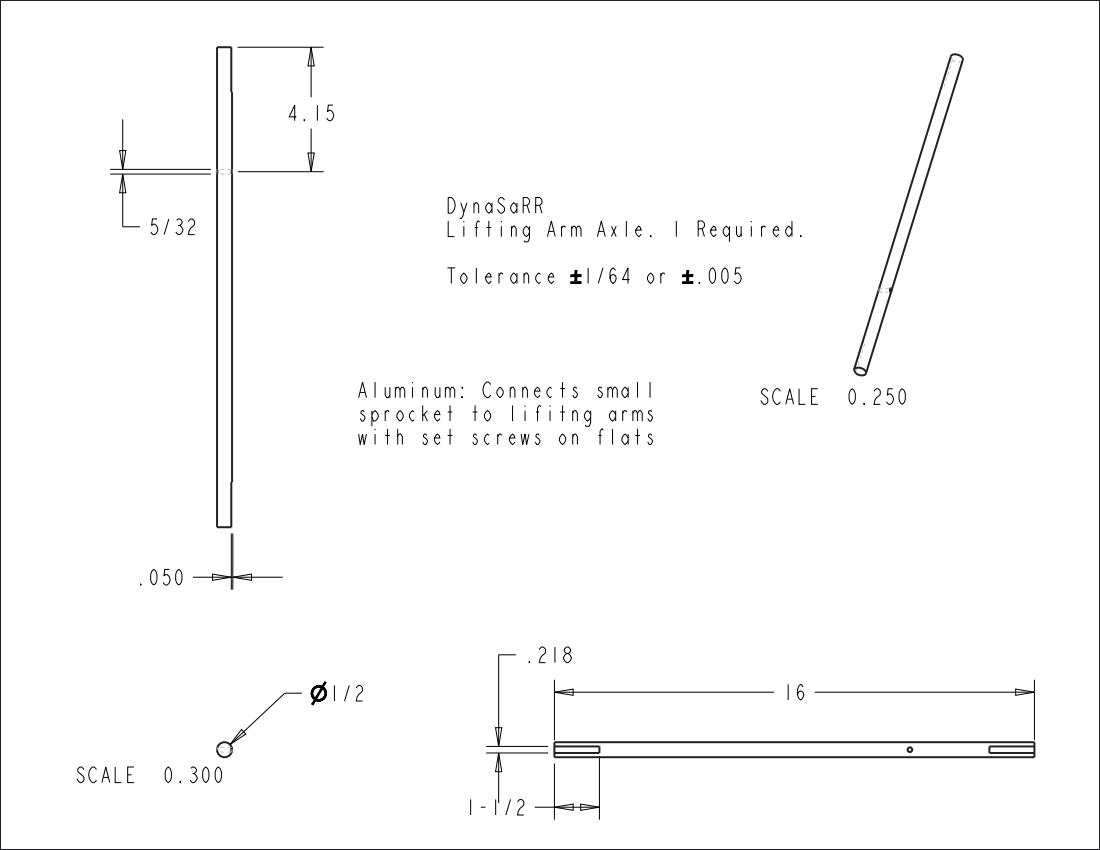
[picture p62: page 1]
DynaSaRR; Lifting Arm Axle. 1; Required.; Tolerance 1/64 or .005; SCALE 0.250; SCALE 0.300

Aluminum: Connects small
sprocket to lifitng arms
with set screws on flats
