sdale28/MAE-322-DynaSaRR/Final_Design_Report/drawings/lifting_arm_drawing.pdf

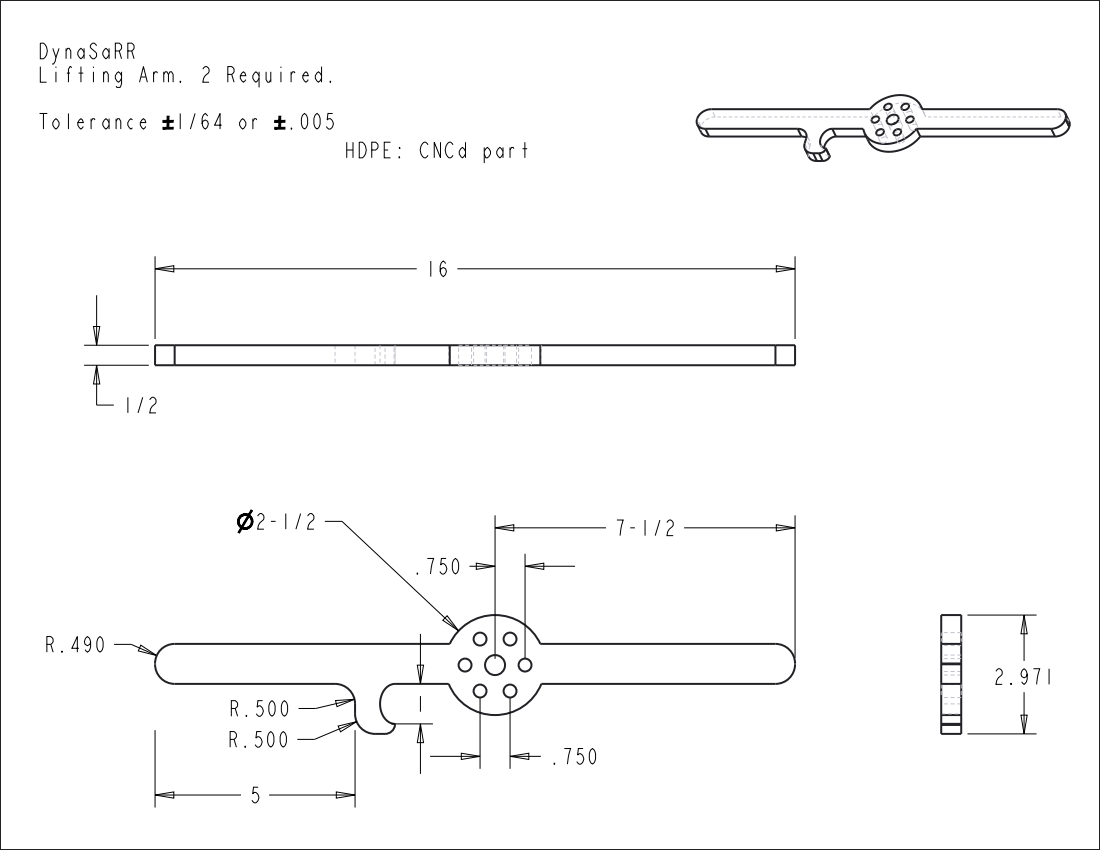
[picture p63: page 1]
HDPE: CNCd; part

DynaSaRR
Lifting Arm. 2 Required.
Tolerance 1/64 or .005
