sdale28/MAE-322-DynaSaRR/Final_Design_Report/drawings/lifting_arm_metal_gripper.pdf

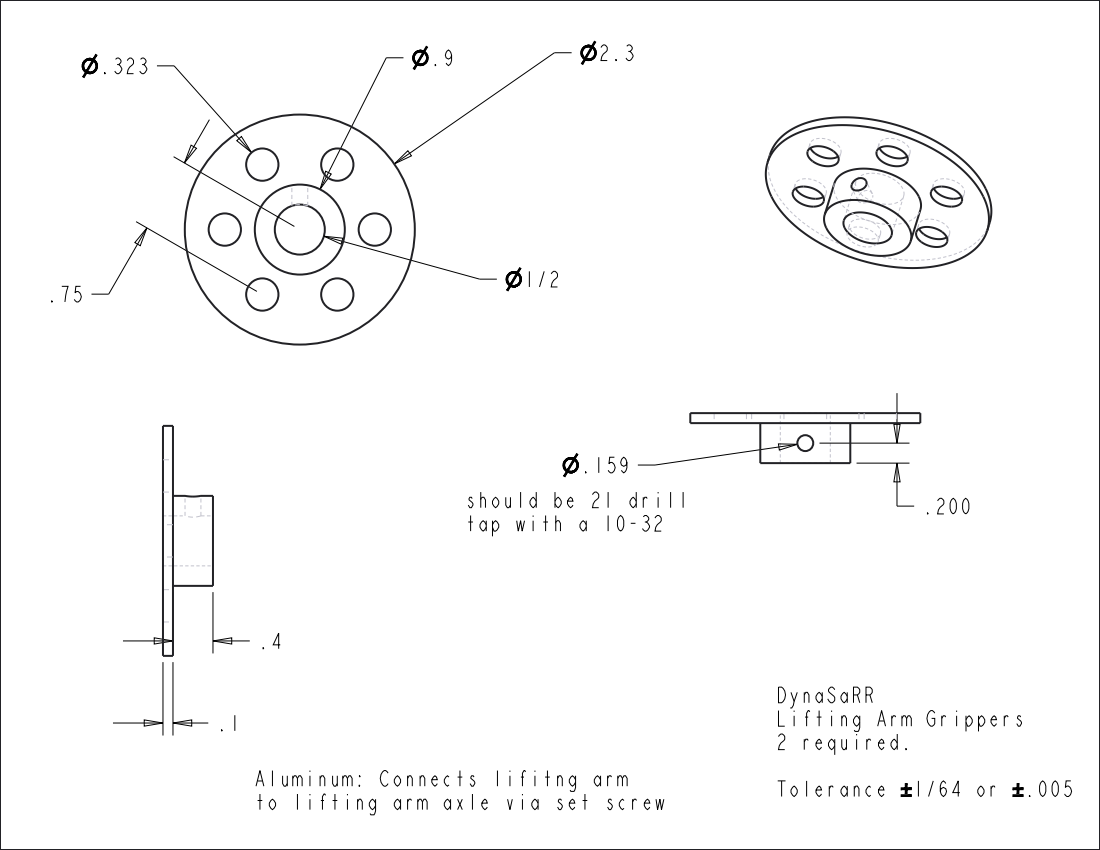
[picture p64: page 1]
should; be 21 drill; tap with a; to lifting arm axle via; set; screw

DynaSaRR
Lifting Arm Grippers
2 required.

Tolerance 1/64 or .005 Aluminum: Connects lifitng arm
