sdale28/MAE-322-DynaSaRR/Final_Design_Report/drawings/lifting_arm_mount.pdf

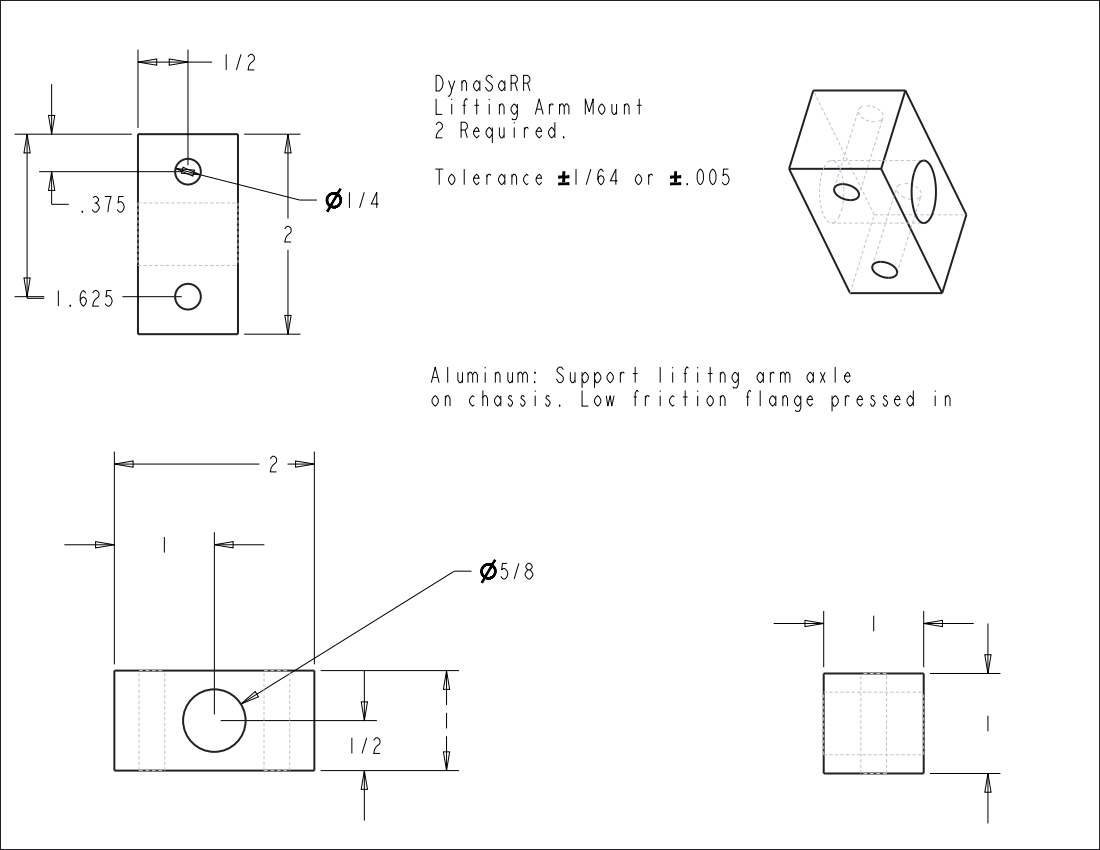
[picture p65: page 1]
on chassis. Low friction; flange pressed

DynaSaRR
Lifting Arm Mount
2 Required.
Tolerance 1/64 or .005

Aluminum: Support lifitng arm axle
