sdale28/MAE-322-DynaSaRR/Final_Design_Report/drawings/lifting_arm_support_cross.pdf

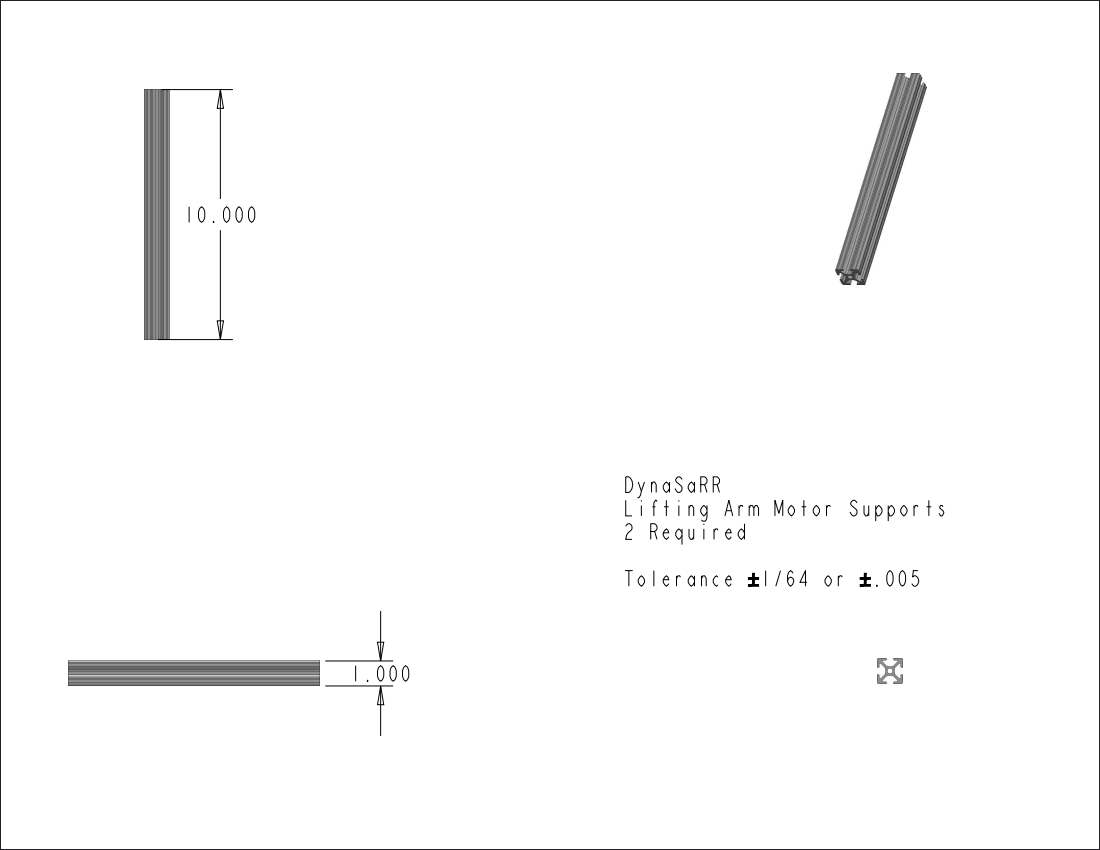
[picture p66: page 1]

DynaSaRR
Lifting Arm Motor Supports
2 Required
Tolerance 1/64 or .005
