sdale28/MAE-322-DynaSaRR/Final_Design_Report/drawings/lifting_arm_washer_plate.pdf

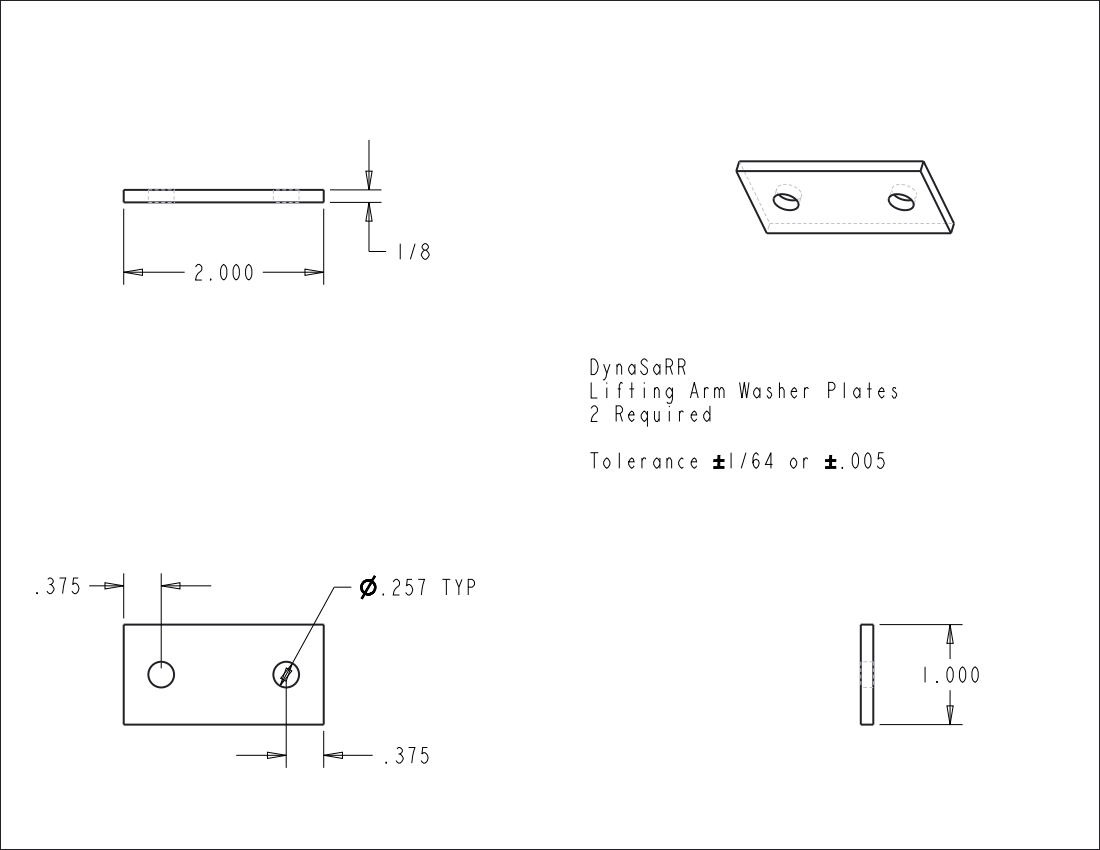
[picture p67: page 1]
.257 TYP

DynaSaRR
Lifting Arm Washer Plates
2 Required
Tolerance 1/64 or .005
