sdale28/MAE-322-DynaSaRR/Final_Design_Report/drawings/lifting_motor_mount.pdf

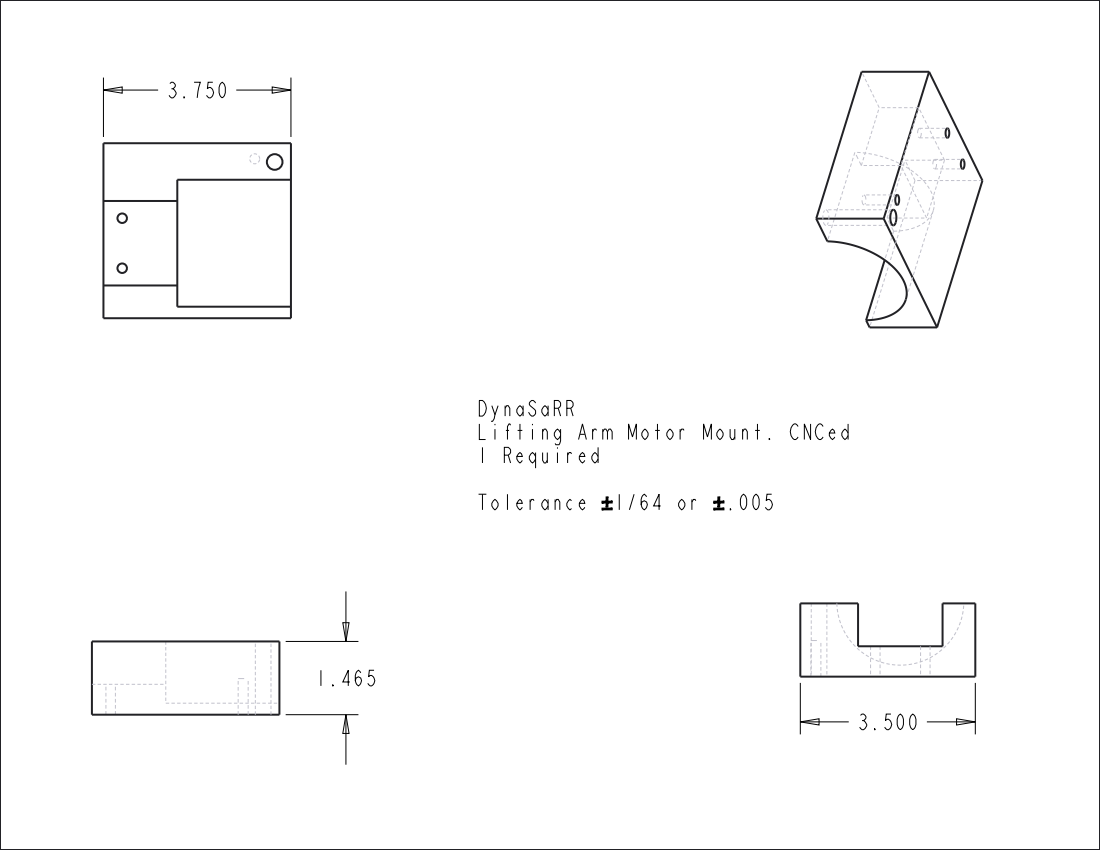
[picture p68: page 1]

DynaSaRR
Lifting Arm Motor Mount. CNCed
1 Required
Tolerance 1/64 or .005
