sdale28/MAE-322-DynaSaRR/Final_Design_Report/drawings/light-sensor_tap.pdf

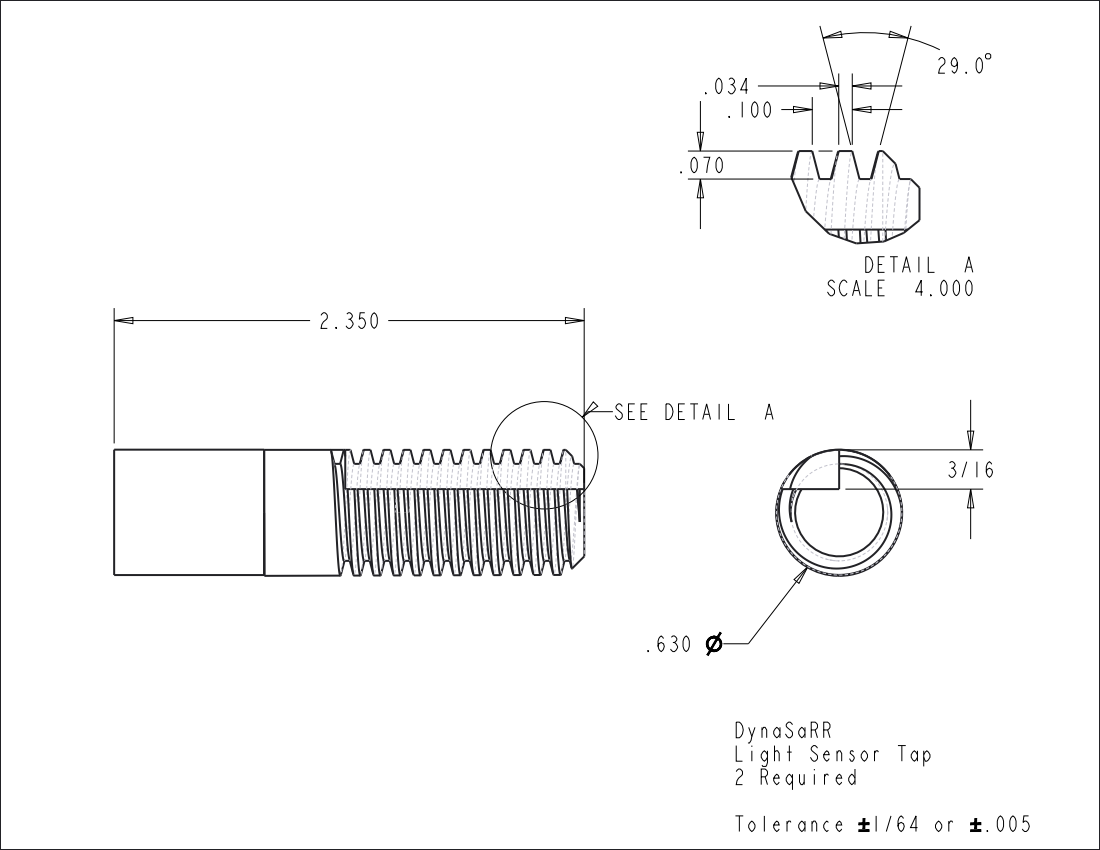
[picture p69: page 1]
SEE DETAIL A; DETAIL A SCALE 4.000

DynaSaRR
Light Sensor Tap
2 Required
Tolerance 1/64 or .005
