sdale28/MAE-322-DynaSaRR/Final_Design_Report/drawings/medkit_arm_gear_spacer_drawing.pdf

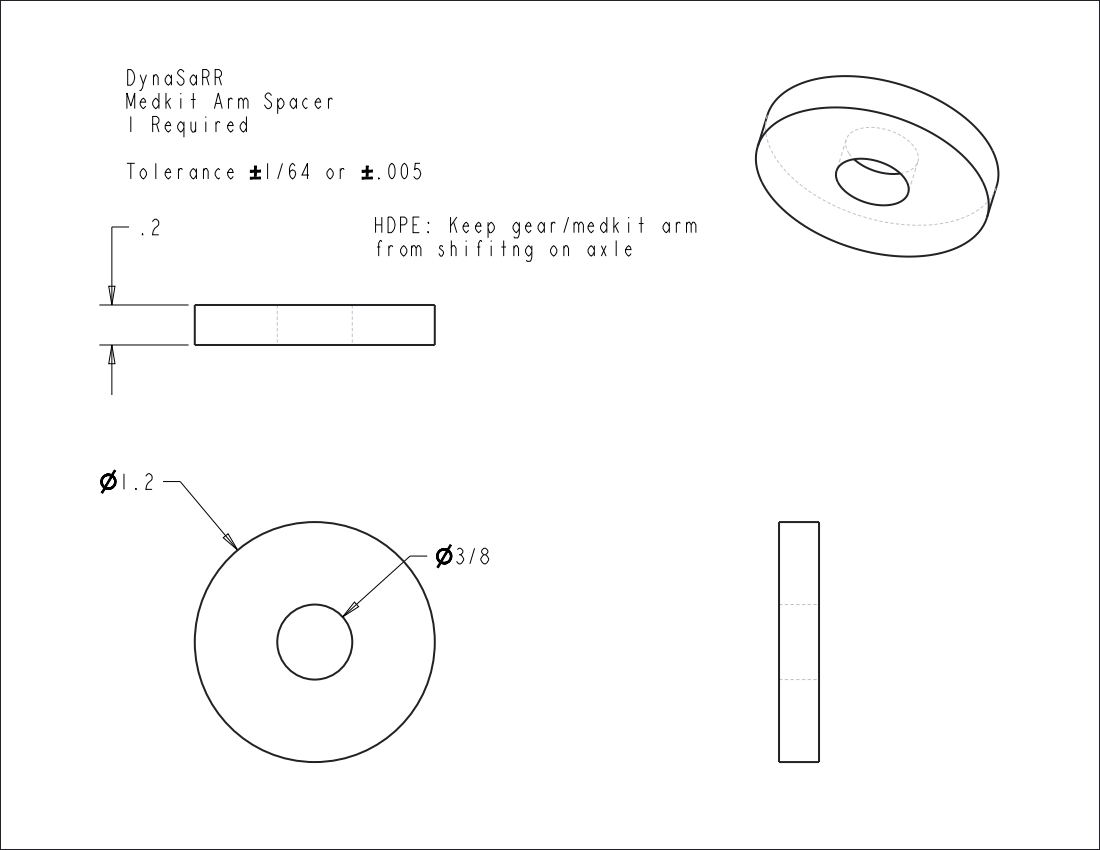
[picture p70: page 1]
DynaSaRR Medkit Arm Spacer 1 Required Tolerance 1/64 or .005; HDPE: Keep gear/medkit; arm

from shifitng on axle
