sdale28/MAE-322-DynaSaRR/Final_Design_Report/drawings/medkit_axle_drawing.pdf

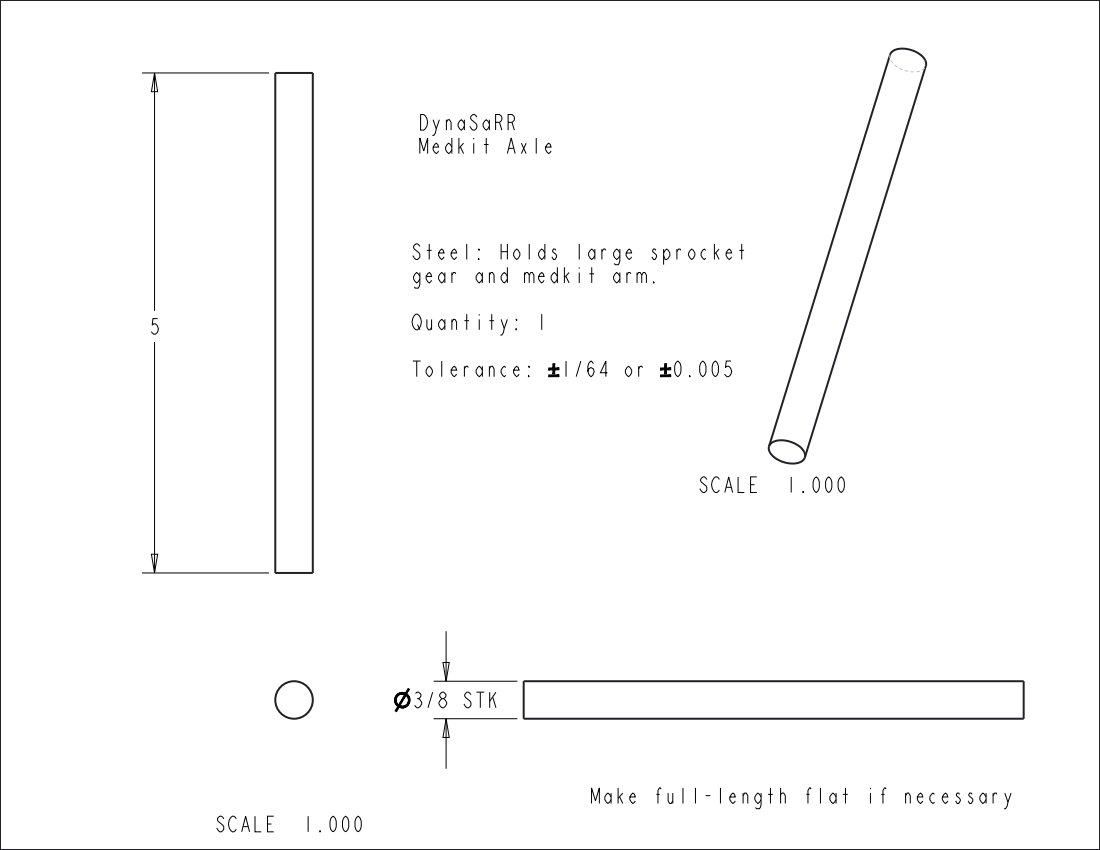
[picture p71: page 1]
3/8 STK; DynaSaRR Medkit Axle; gear and; medkit arm.; Make full-length flat; if necessary; SCALE 1.000

Steel: Holds large sprocket
Quantity: 1
Tolerance: 1/64 or 0.005
