sdale28/MAE-322-DynaSaRR/Final_Design_Report/drawings/medkit_grabber_attchmnt_drawing.pdf

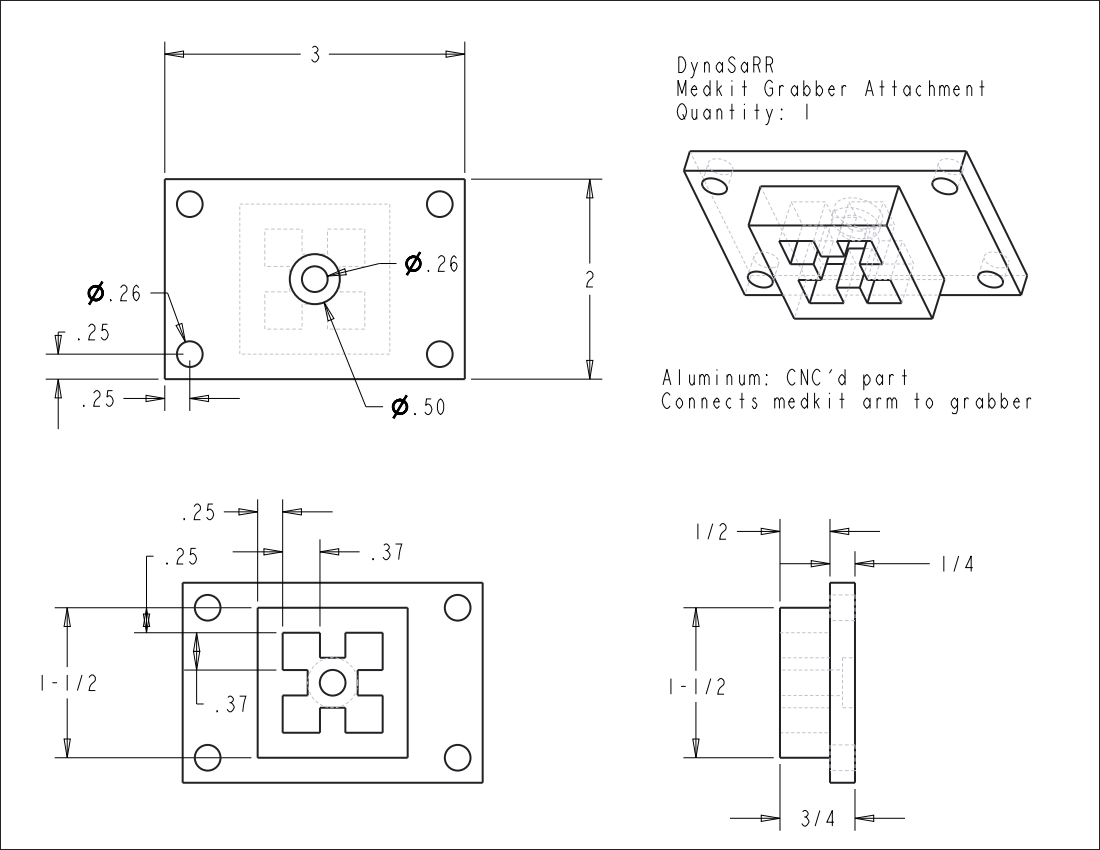
[picture p72: page 1]
Aluminum: CNC'd; part

DynaSaRR
Medkit Grabber Attachment
Quantity: 1

Connects medkit arm to grabber
