sdale28/MAE-322-DynaSaRR/Final_Design_Report/drawings/medkit_limit_switch_holder_frnt.pdf

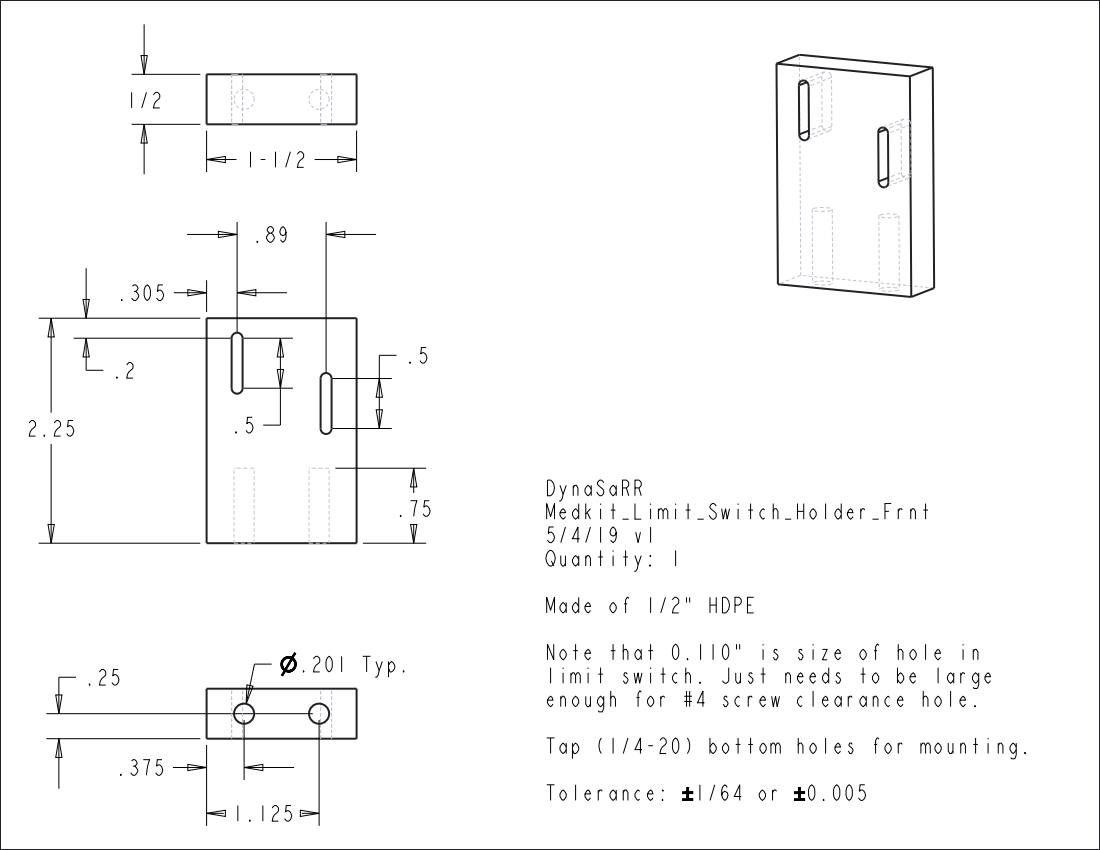
[picture p73: page 1]
.201 Typ.; limit switch. Just; needs to be large; Tap (1/4-20) bottom holes for; mounting.

DynaSaRR
Medkit_Limit_Switch_Holder_Frnt
Quantity: 1
Made of 1/2" HDPE
Note that 0.110" is size of hole in
enough for #4 screw clearance hole.
Tolerance: 1/64 or 0.005
