sdale28/MAE-322-DynaSaRR/Final_Design_Report/drawings/medkit_motor_mount_bottom.pdf

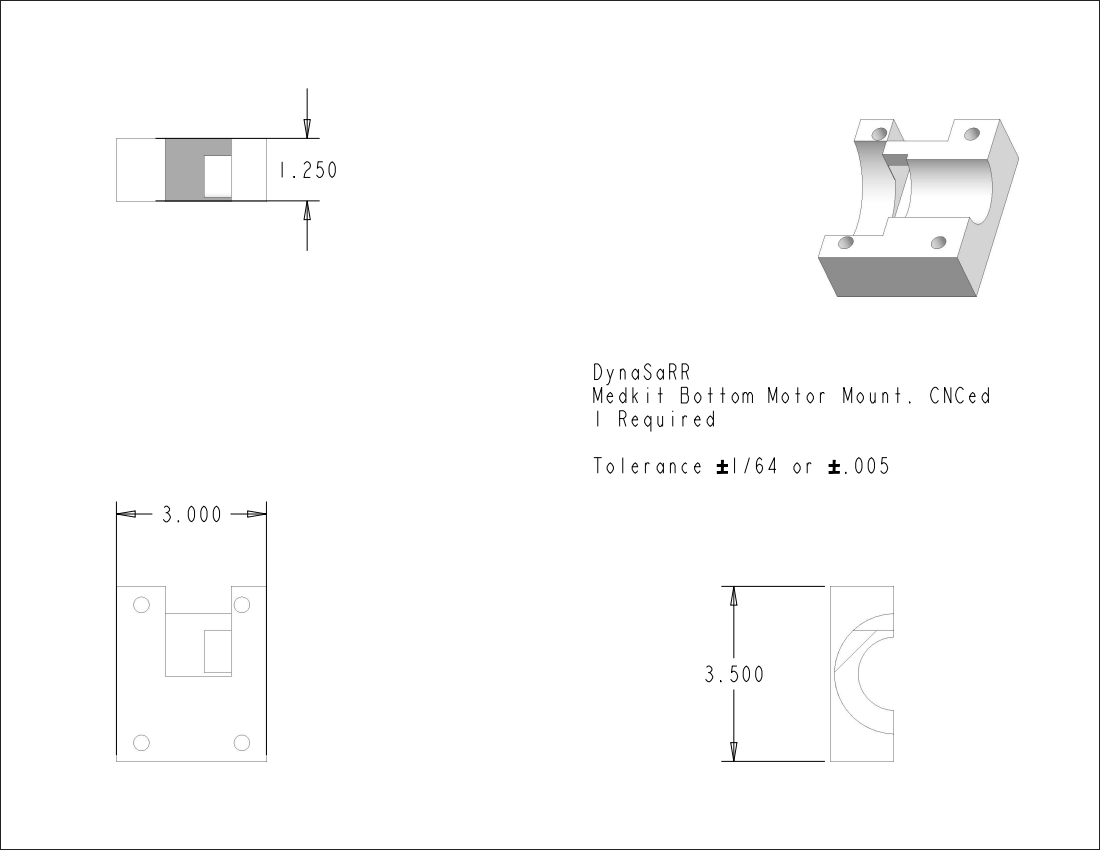
[picture p74: page 1]

DynaSaRR
Medkit Bottom Motor Mount. CNCed
1 Required
Tolerance 1/64 or .005
