sdale28/MAE-322-DynaSaRR/Final_Design_Report/drawings/medkit_motor_mount_top.pdf

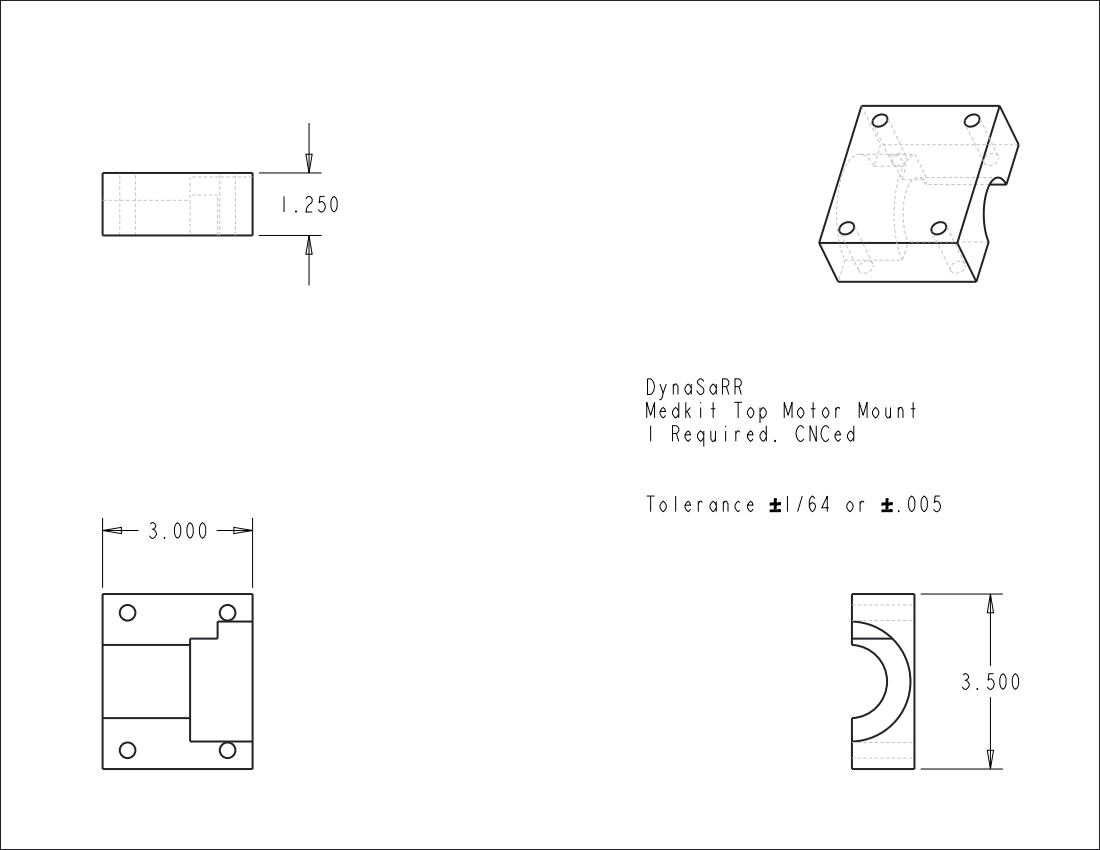
[picture p75: page 1]
Tolerance 1/64 or .005

DynaSaRR
Medkit Top Motor Mount
1 Required. CNCed
