sdale28/MAE-322-DynaSaRR/Final_Design_Report/drawings/medkit_secure_l_beam.pdf

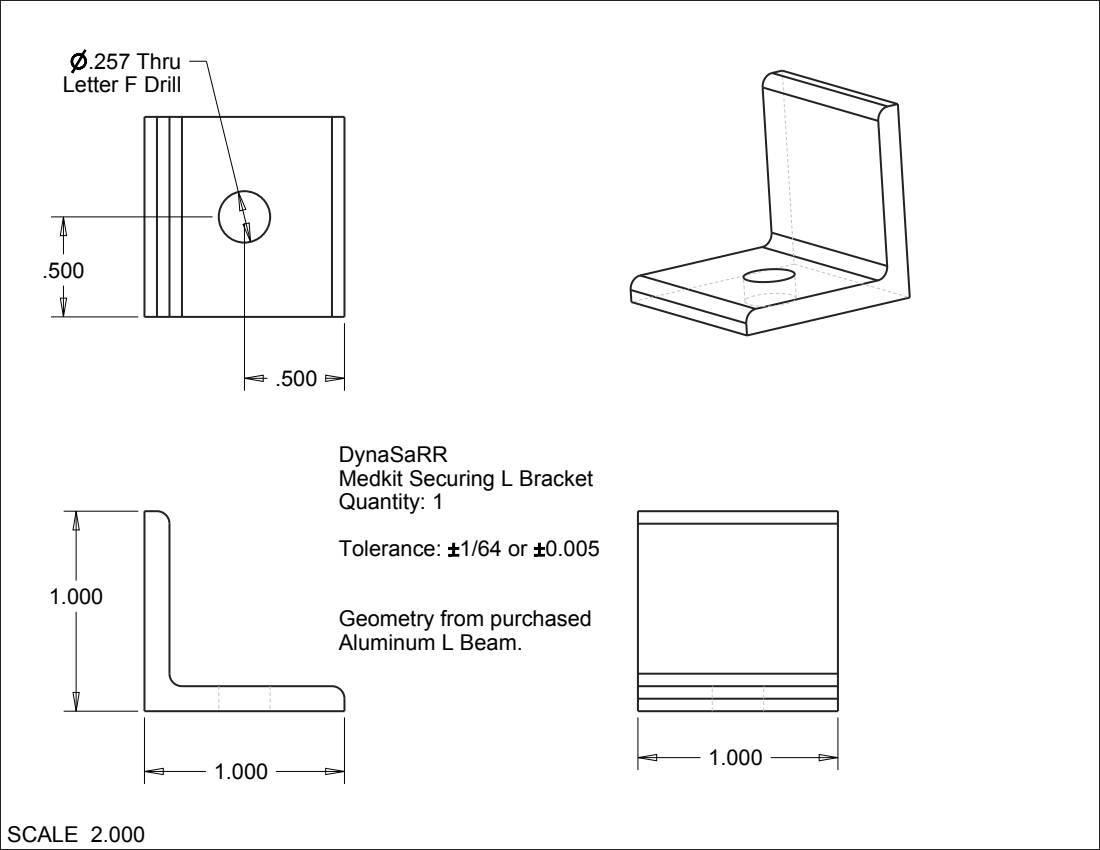
[picture p76: page 1]
.257 Thru Letter F Drill; SCALE 2.000

DynaSaRR
Medkit Securing L Bracket
Quantity: 1
Tolerance: 1/64 or 0.005

Geometry from purchased
Aluminum L Beam.
