sdale28/MAE-322-DynaSaRR/Final_Design_Report/drawings/medkit_subassembly_v2.pdf

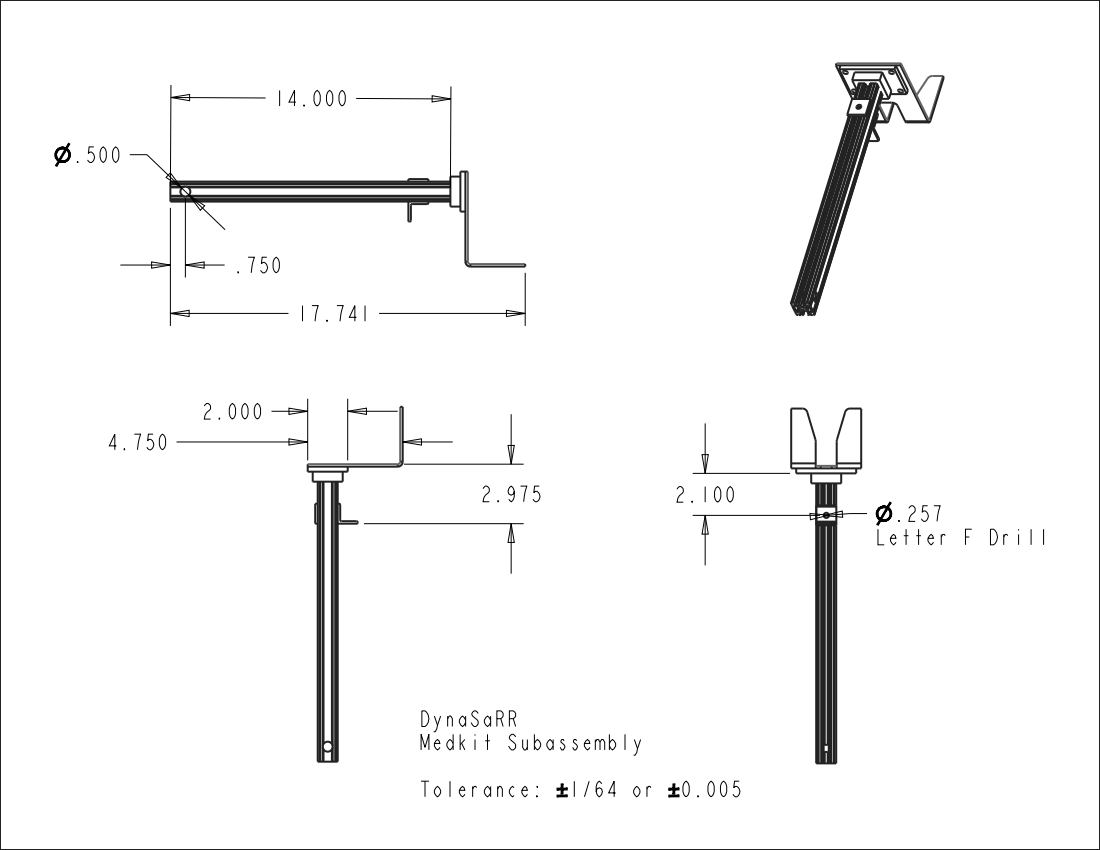
[picture p77: page 1]
.257 Letter F Drill; DynaSaRR Medkit Subassembly Tolerance: 1/64 or 0.005
