sdale28/MAE-322-DynaSaRR/Final_Design_Report/drawings/medkit_washer_plate_drawing.pdf

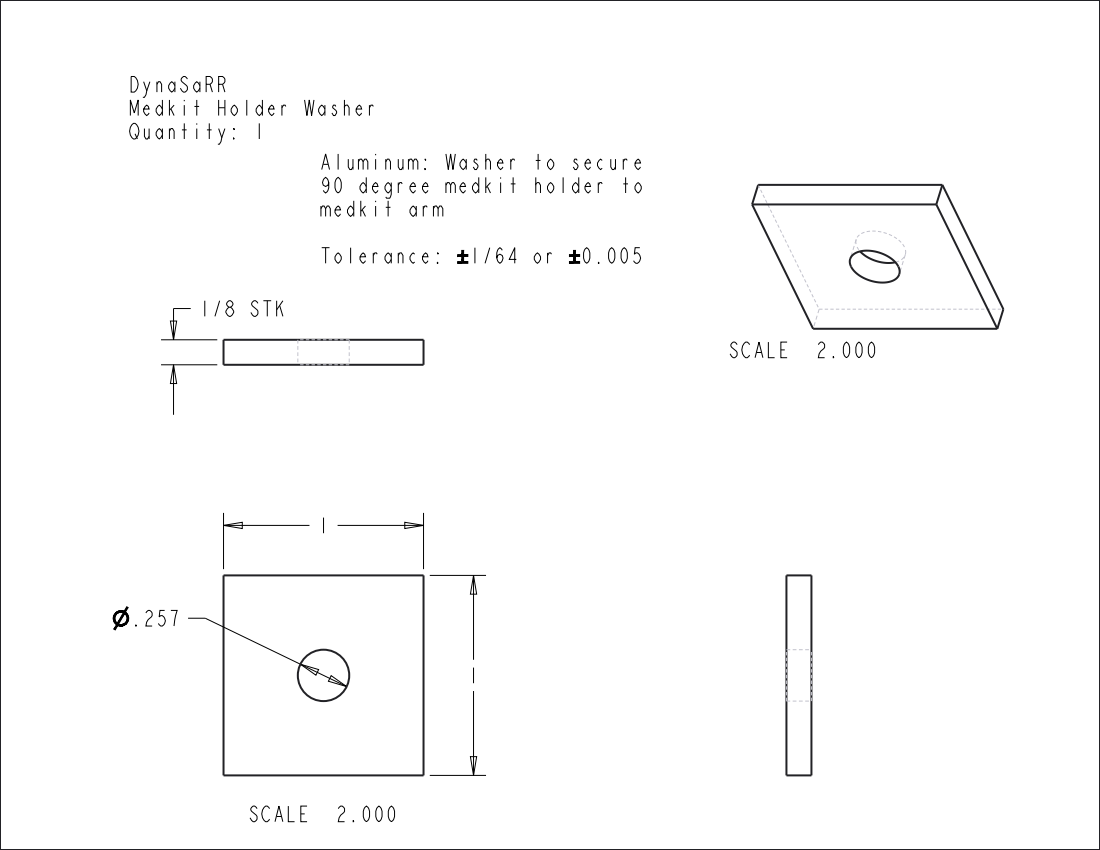
[picture p78: page 1]
1/8 STK; 90 degree medkit holder; SCALE 2.000

DynaSaRR
Medkit Holder Washer
Quantity: 1

Aluminum: Washer to secure
medkit arm
Tolerance: 1/64 or 0.005
