sdale28/MAE-322-DynaSaRR/Final_Design_Report/drawings/top_cross_bar.pdf

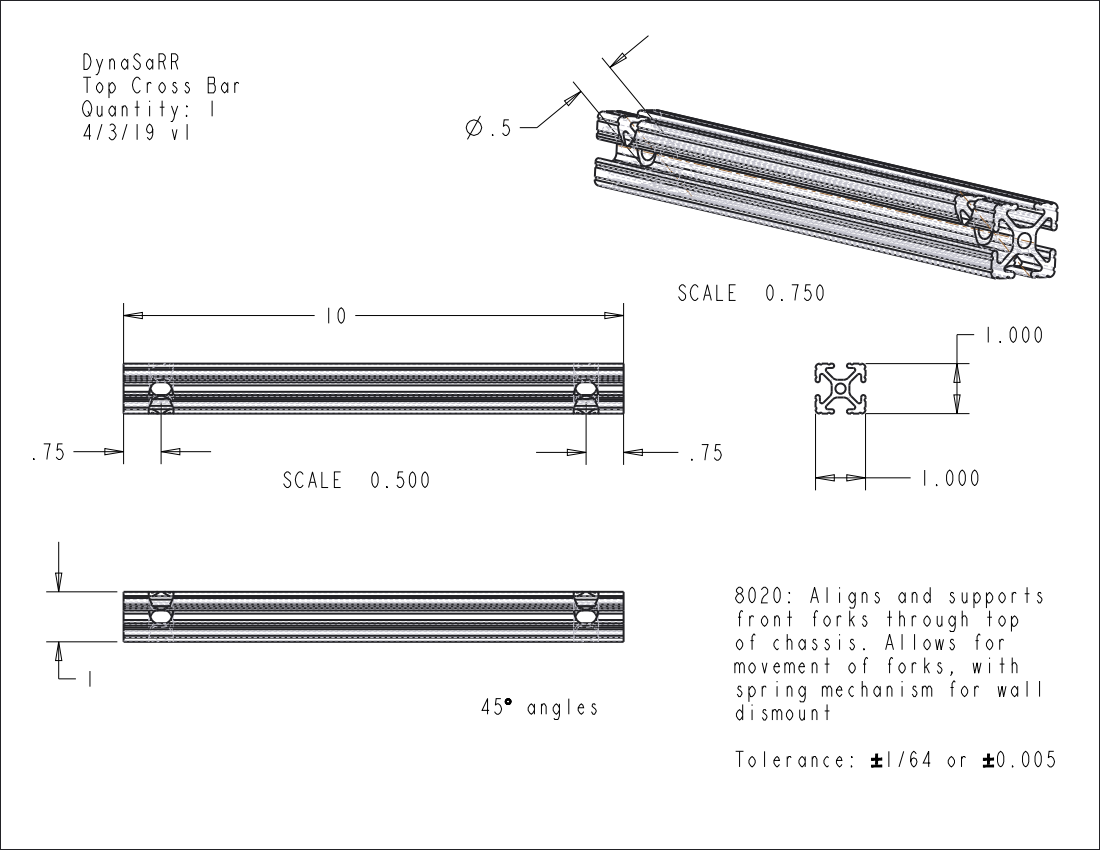
[picture p79: page 1]
DynaSaRR Top Cross Bar Quantity: 1 4/3/19 v1; 45 angles; 8020: Aligns and; supports; SCALE 0.500; SCALE 0.750

front forks through top
of chassis. Allows for
movement of forks, with
spring mechanism for wall
dismount
Tolerance: 1/64 or 0.005
