sdale28/MAE-322-DynaSaRR/Final_Design_Report/drawings/washer-plate-drawing.pdf

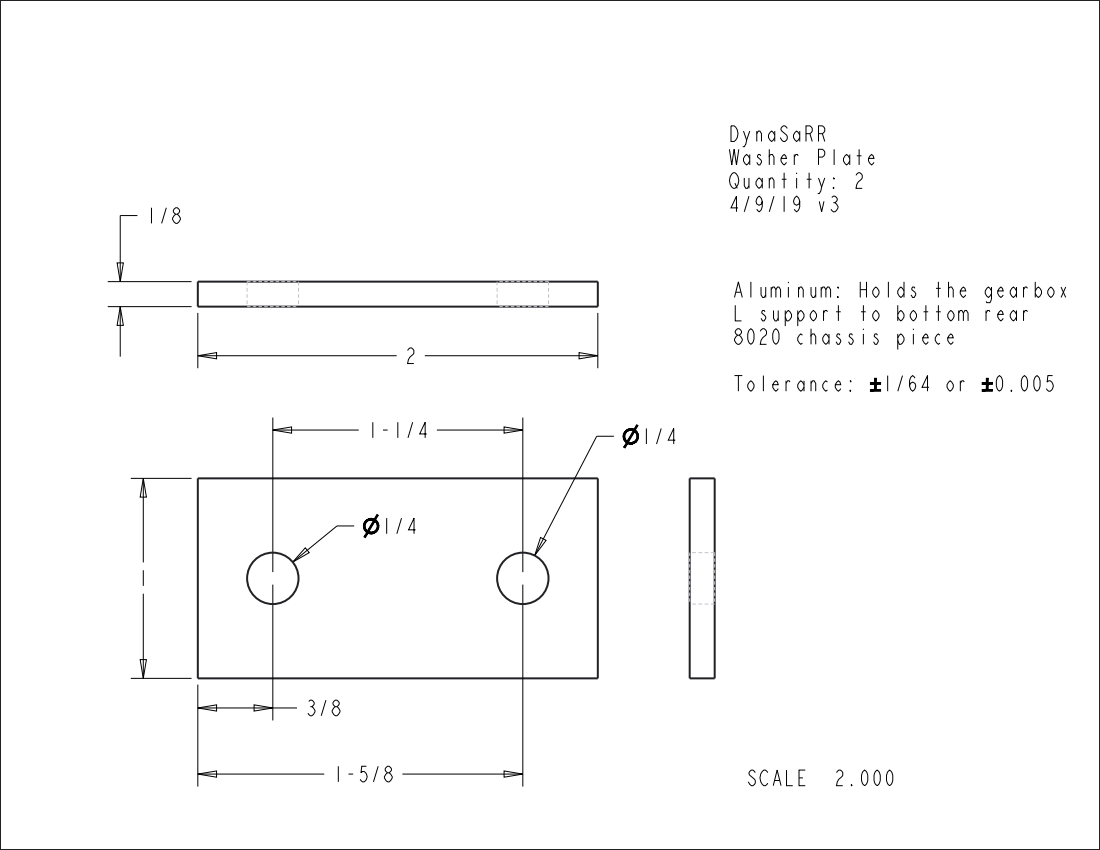
[picture p80: page 1]
DynaSaRR Washer Plate Quantity: 2 4/9/19 v3; SCALE 2.000

Aluminum: Holds the gearbox
L support to bottom rear
8020 chassis piece
Tolerance: 1/64 or 0.005
