sdale28/MAE-322-DynaSaRR/Final_Design_Report/drawings/cross_bar.pdf

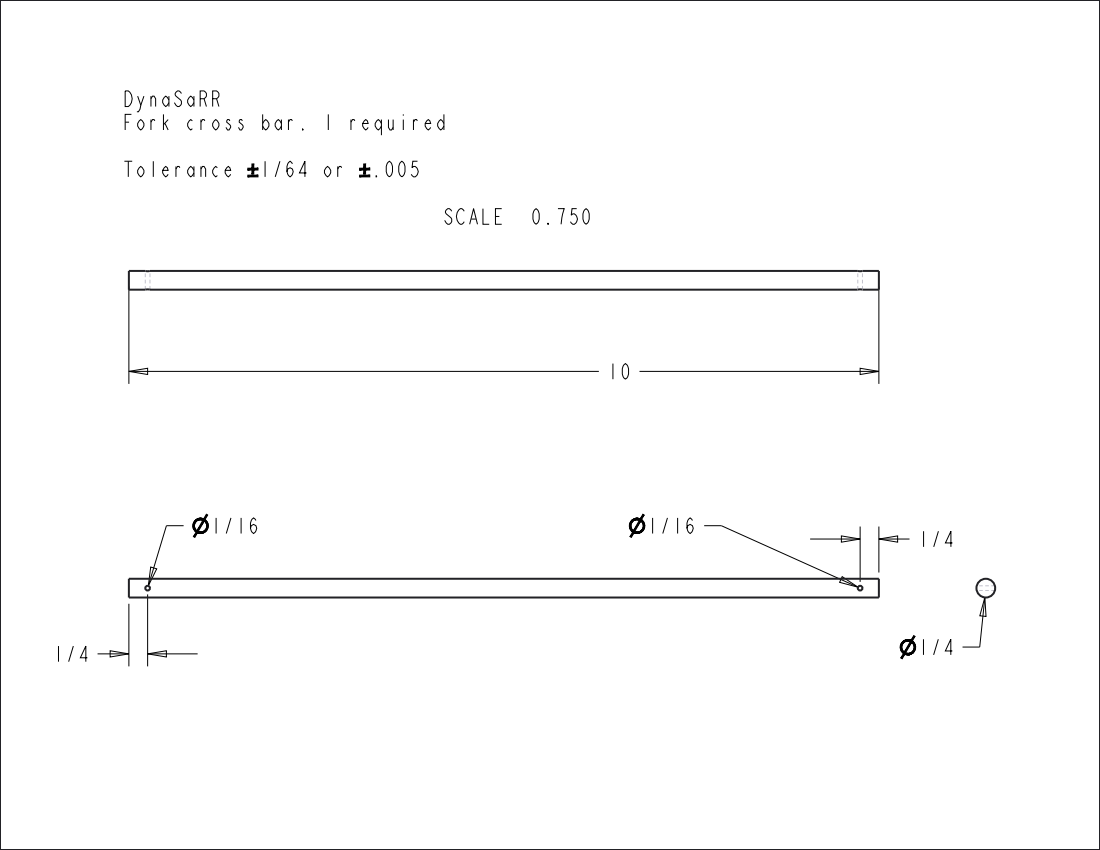
[picture p81: page 1]
SCALE 0.750

DynaSaRR
Fork cross bar. 1 required
Tolerance 1/64 or .005
