sdale28/MAE-322-DynaSaRR/Final_Design_Report/drawings/grabber_drawing.pdf

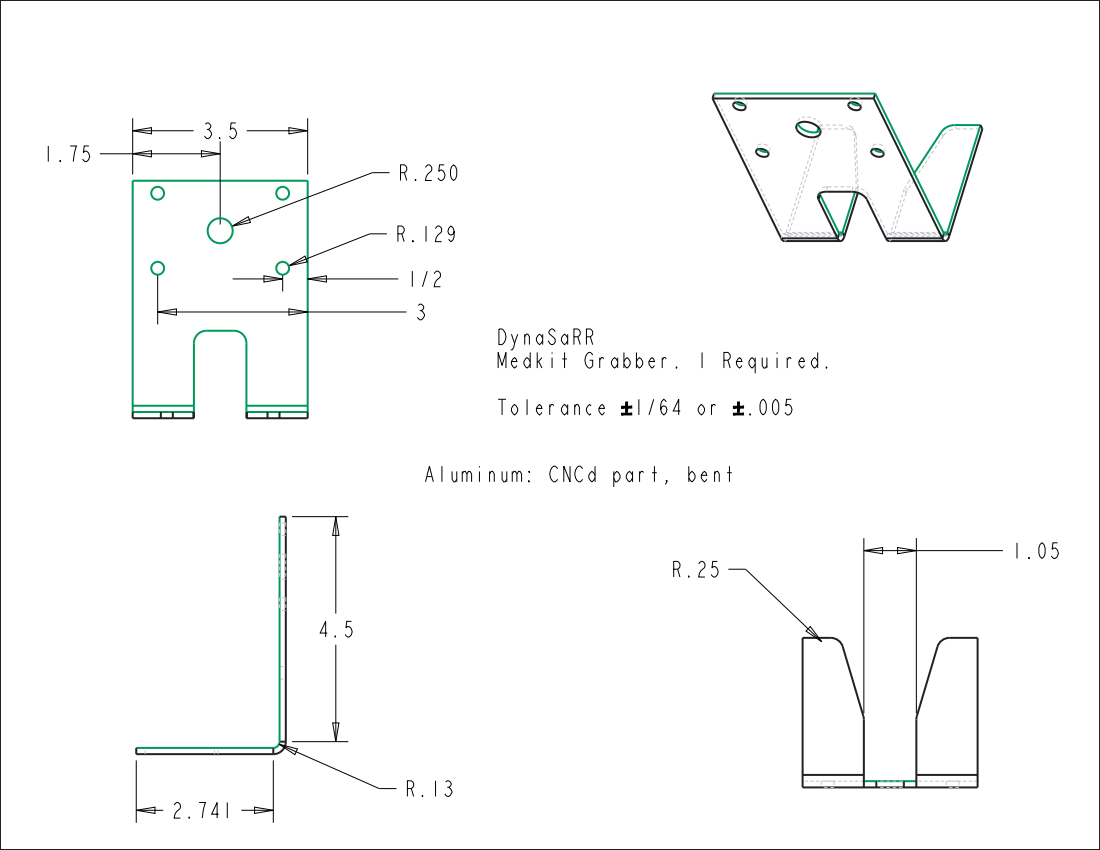
[picture p82: page 1]
DynaSaRR Medkit Grabber. 1 Required. Tolerance 1/64 or .005; Aluminum: CNCd; part, bent
