sdale28/MAE-322-DynaSaRR/Final_Design_Report/drawings/polycarbonate_drawing_bottom.pdf

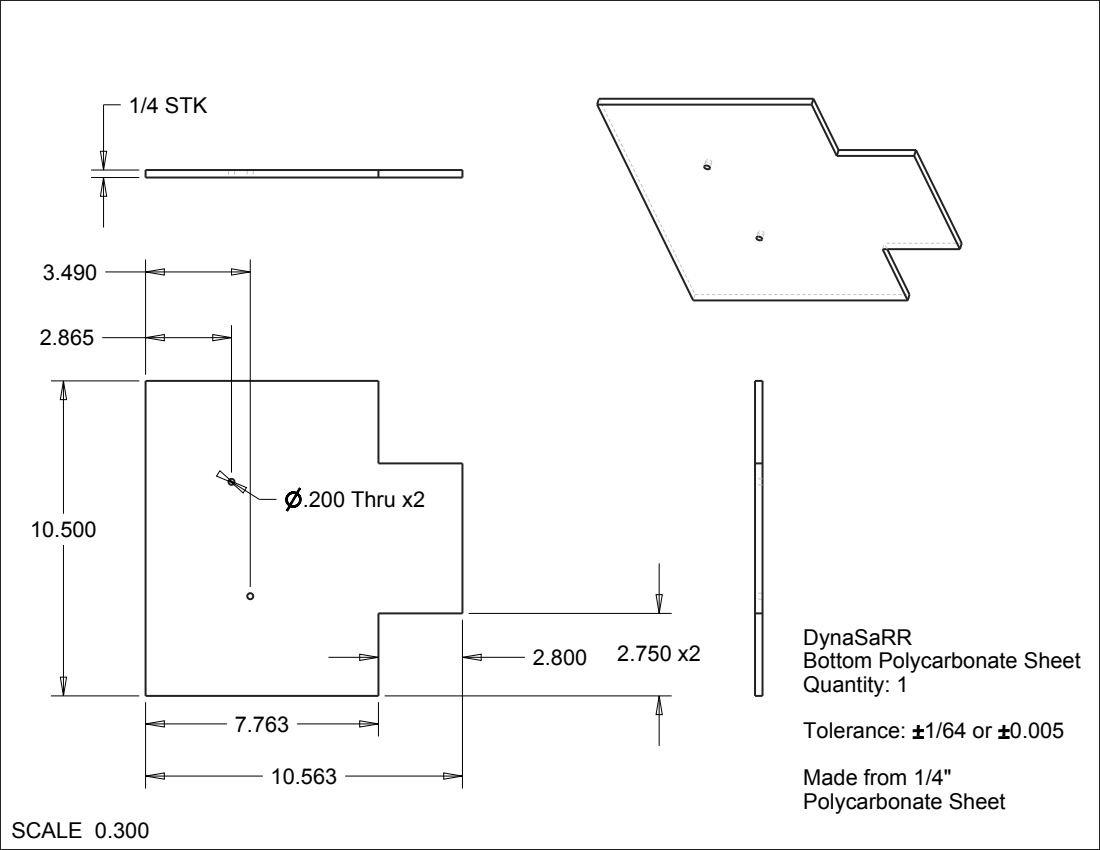
[picture p83: page 1]
.200 Thru x2; 1/4 STK; DynaSaRR; SCALE 0.300

Bottom Polycarbonate Sheet
Quantity: 1
Tolerance: 1/64 or 0.005
Made from 1/4"
Polycarbonate Sheet
