sdale28/MAE-322-DynaSaRR/(commit log)

2019-03-06 Sensors Initial changes
2019-04-16 Note about Arduino compatibility with Teensyduino
2019-04-16 Final clarification of Arduino versioning.
2019-04-16 Arduino clarification
2019-04-30 Added printSensors()
2019-05-01 limit switches
2019-05-13 Light code not working, but still there.
    [DynaSaRR.ino]
2019-05-15 Final upload.
    [bill-of-materials_v2.csv, logbook_v2.csv, total-time_v1.csv]
